drewsum/USB_Hub/README.md

# USB_Hub
A DIY USB hub with digital monitoring on all ports
