drewsum/USB_Hub/(threads)

Thread 1 (2020-08-25):

Use Correct USB Load Switches with USB Hub IC

drewsum, 2020-08-25:
Use something like this: TPS2044

https://www.ti.com/lit/ug/sllu190/sllu190.pdf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

Closed 2023-11-11.

Thread 4 (2023-11-11):

Rev A Issues/ECOs

drewsum, 2023-11-11:
Rev A design will not enumerate properly as built:

1. External EEPROM was problematic to program. Consider removing.
2. Missing 1.5k pullup resistor on upstream facing port D+. This tells the upstream facing port this is a full speed device so that it can be enumerated. I added an 0805 1.5k pullup from C14.1.1 to R905.1

drewsum, 2023-11-11:
See https://e2e.ti.com/support/interface-group/interface/f/interface-forum/768124/tusb2046b-tusb2046b-usb-detection-issue for a complete circuit, I was missing a ton of stuff
