drewsum/USB_Hub/hdw/USB_Hub/USB_Hub.pdf

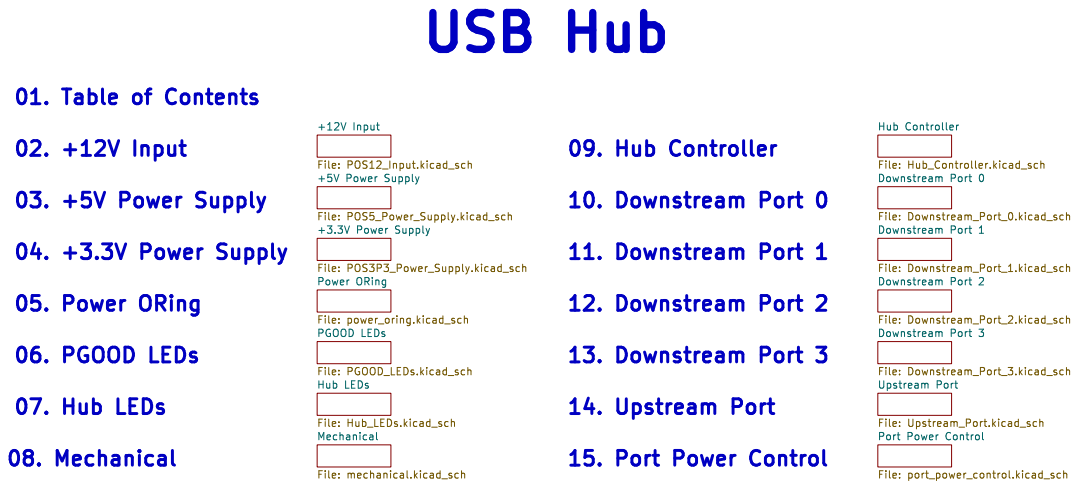
[picture p1: page 1]

Id: 1/15 Title: USB Hub

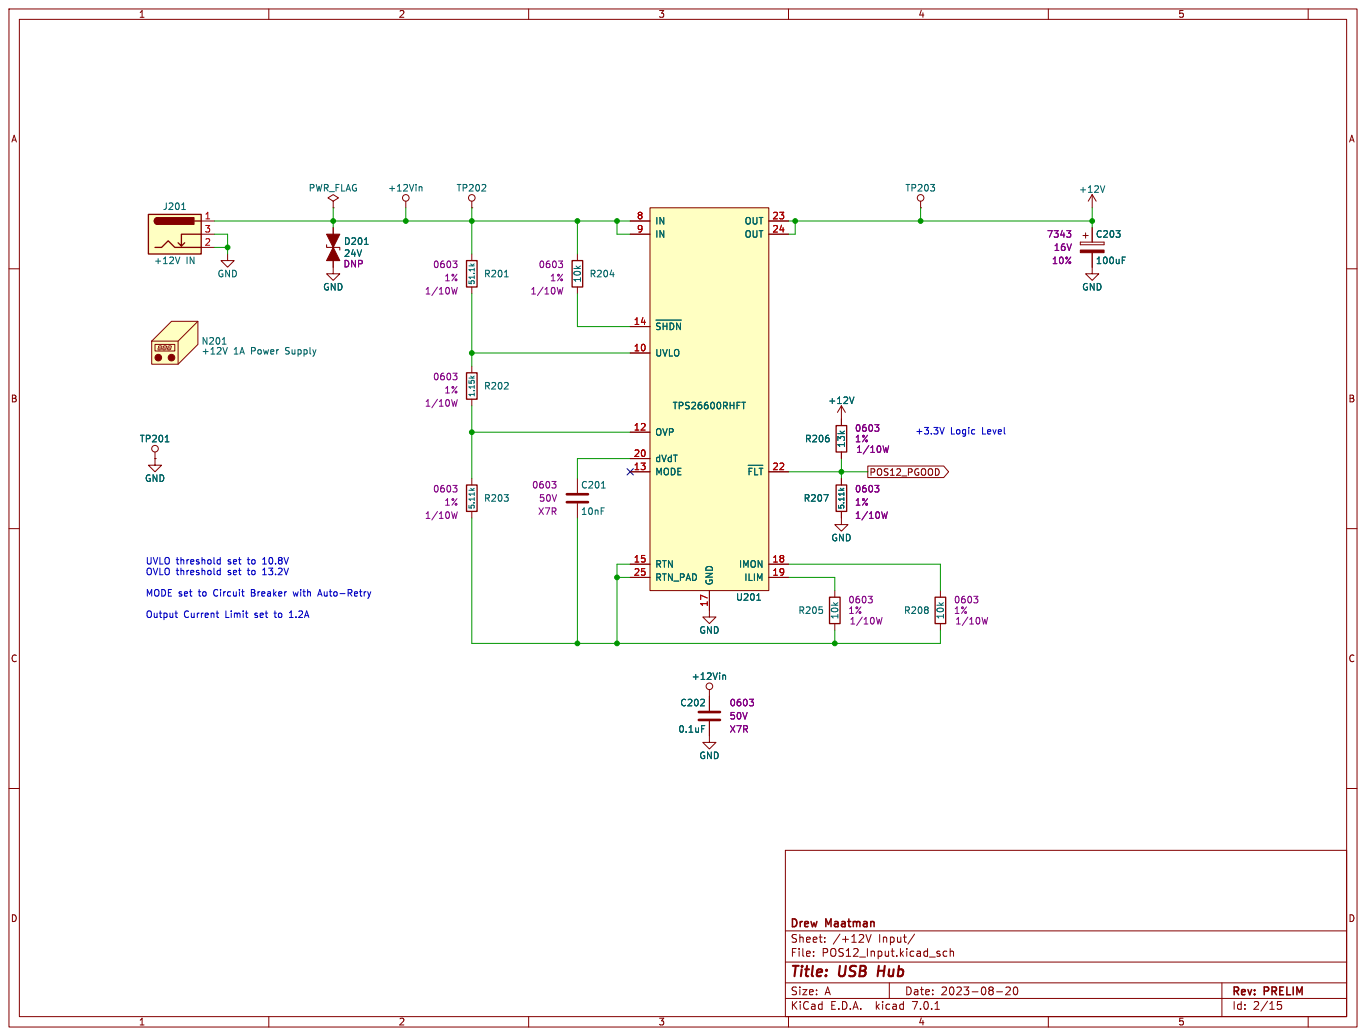
[picture p2: page 2]

Output Current Limit set to 1.2A

Id: 2/15 Title: USB Hub

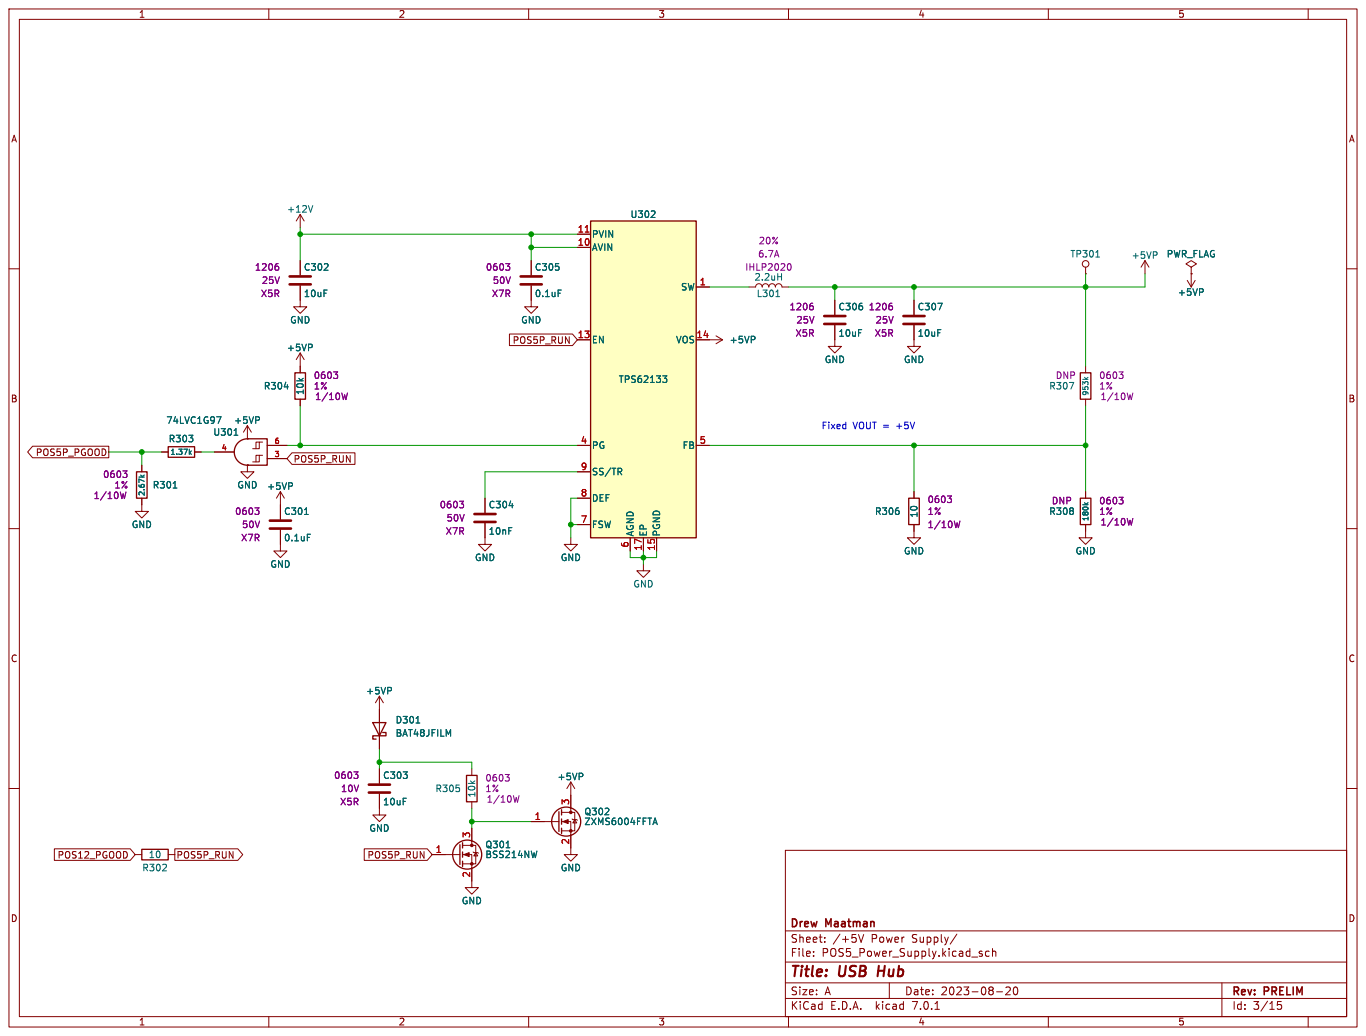
[picture p3: page 3]

6 FSW 7 DEF 8 SS/TR 9 U302 TPS62133 GND

6 FSW 7 DEF 8 SS/TR 9 C302

Id: 3/15 Title: USB Hub

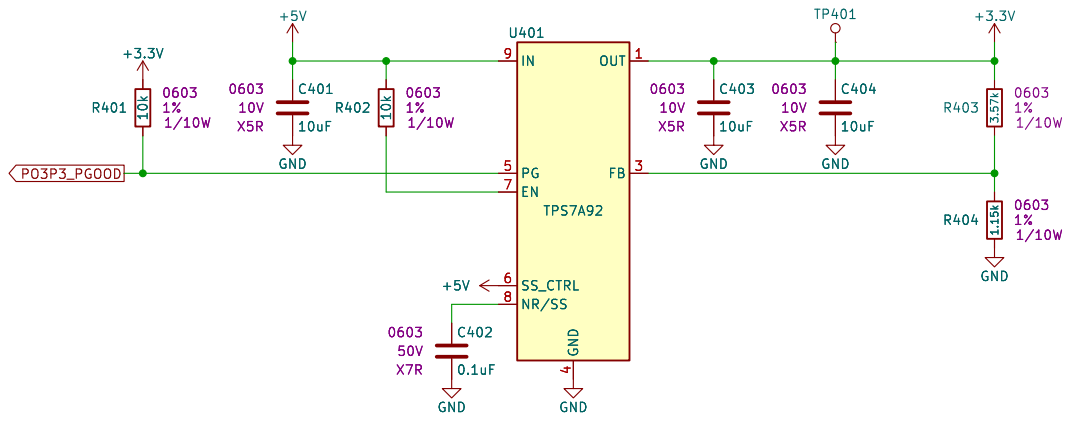
[picture p4: page 4]

4 PG 5 SS_CTRL 6 EN 7 NR/SS 8

Id: 4/15 Title: USB Hub

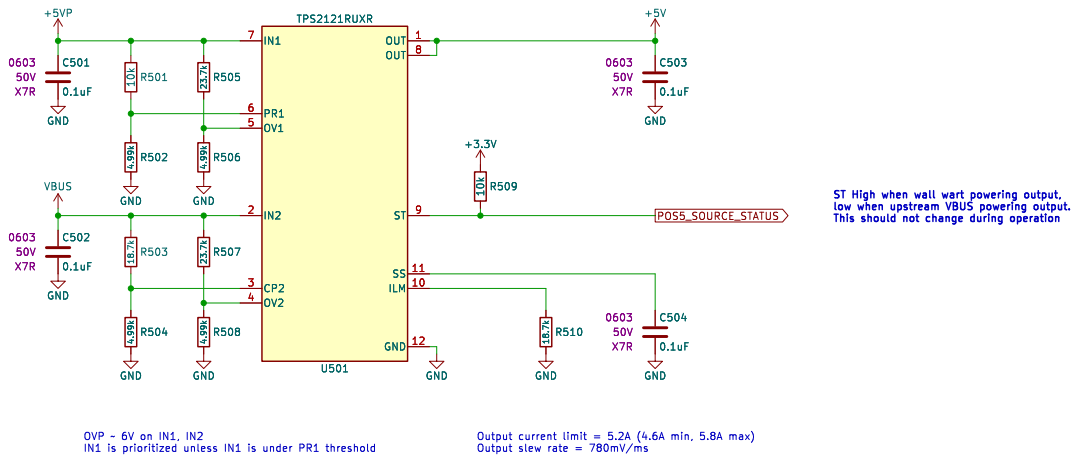
[picture p5: page 5]

ST High when wall wart powering output,
low when upstream VBUS powering output. This should not change during operation

Output slew rate = 780mV/ms OVP ~ 6V on IN1, IN2

Output current limit = 5.2A (4.6A min, 5.8A max)

Id: 5/15 Title: USB Hub

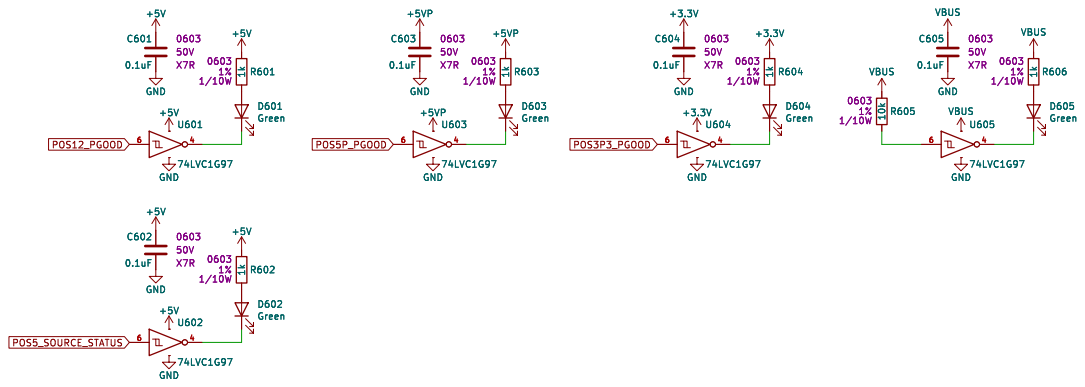
[picture p6: page 6]

Id: 6/15 Title: USB Hub

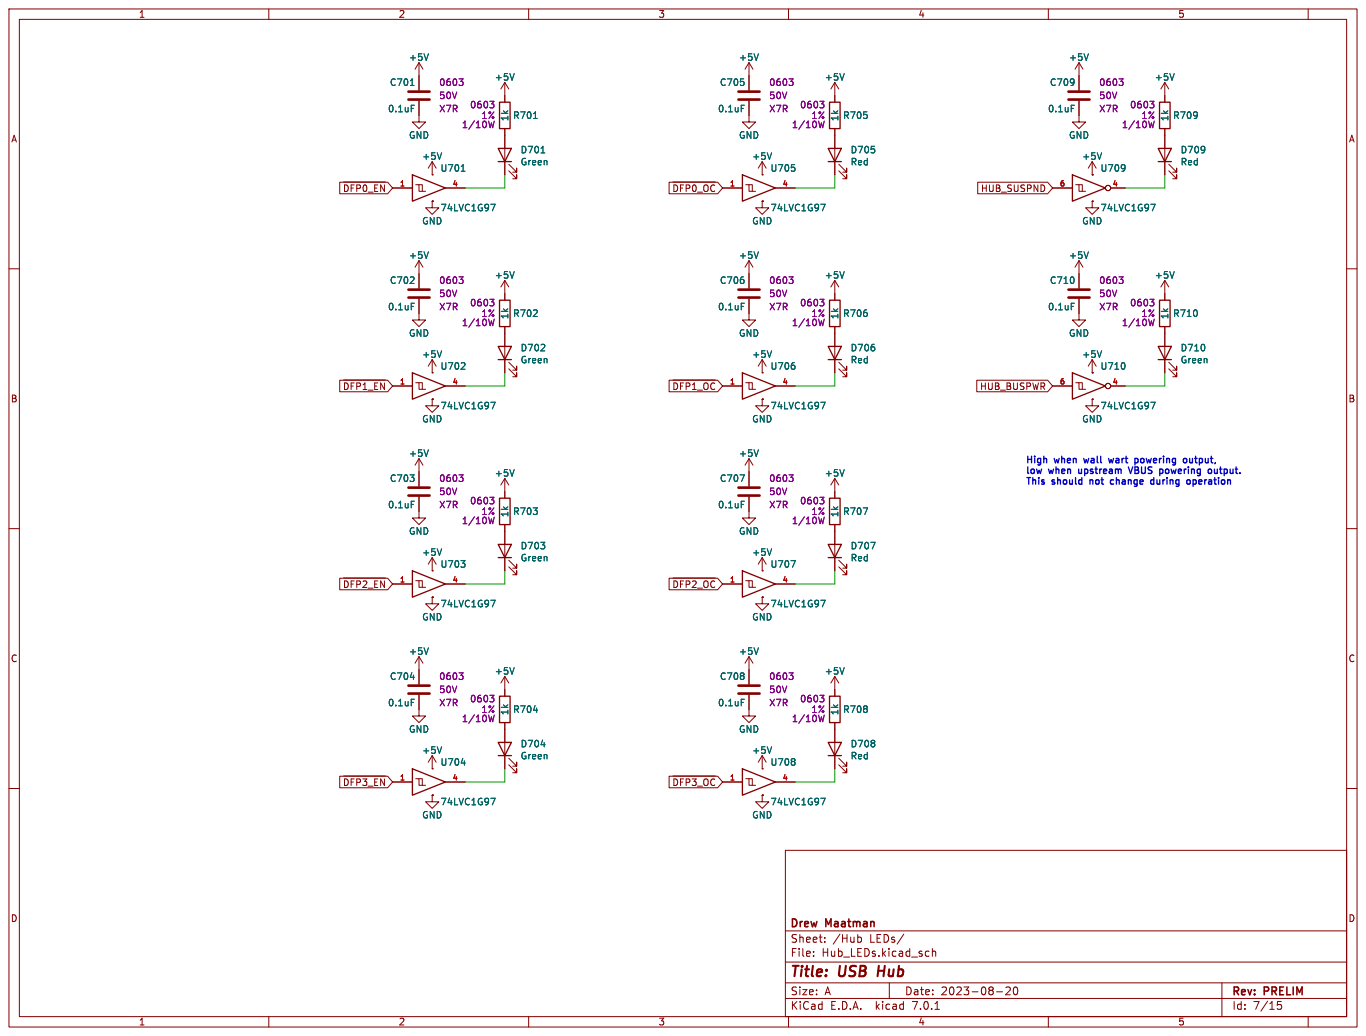
[picture p7: page 7]

low when upstream VBUS powering output. This should not change during operation U702

High when wall wart powering output,

Id: 7/15 Title: USB Hub

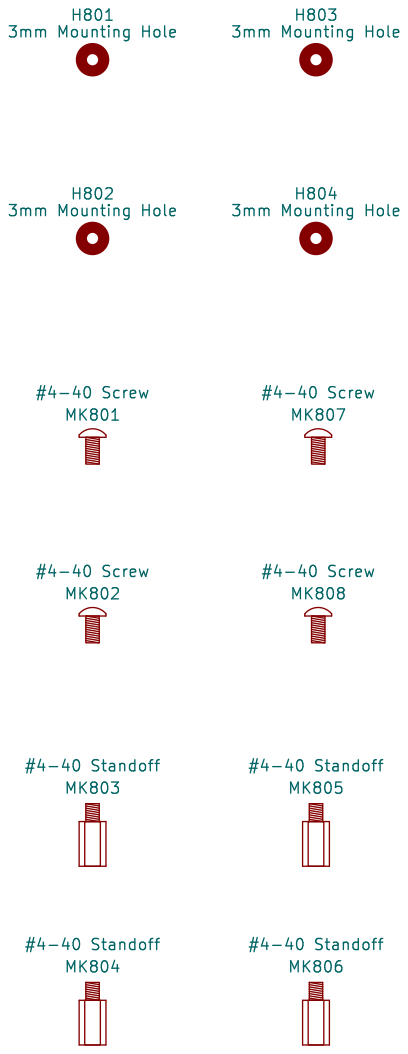
[picture p8: page 8]

Id: 8/15 Title: USB Hub

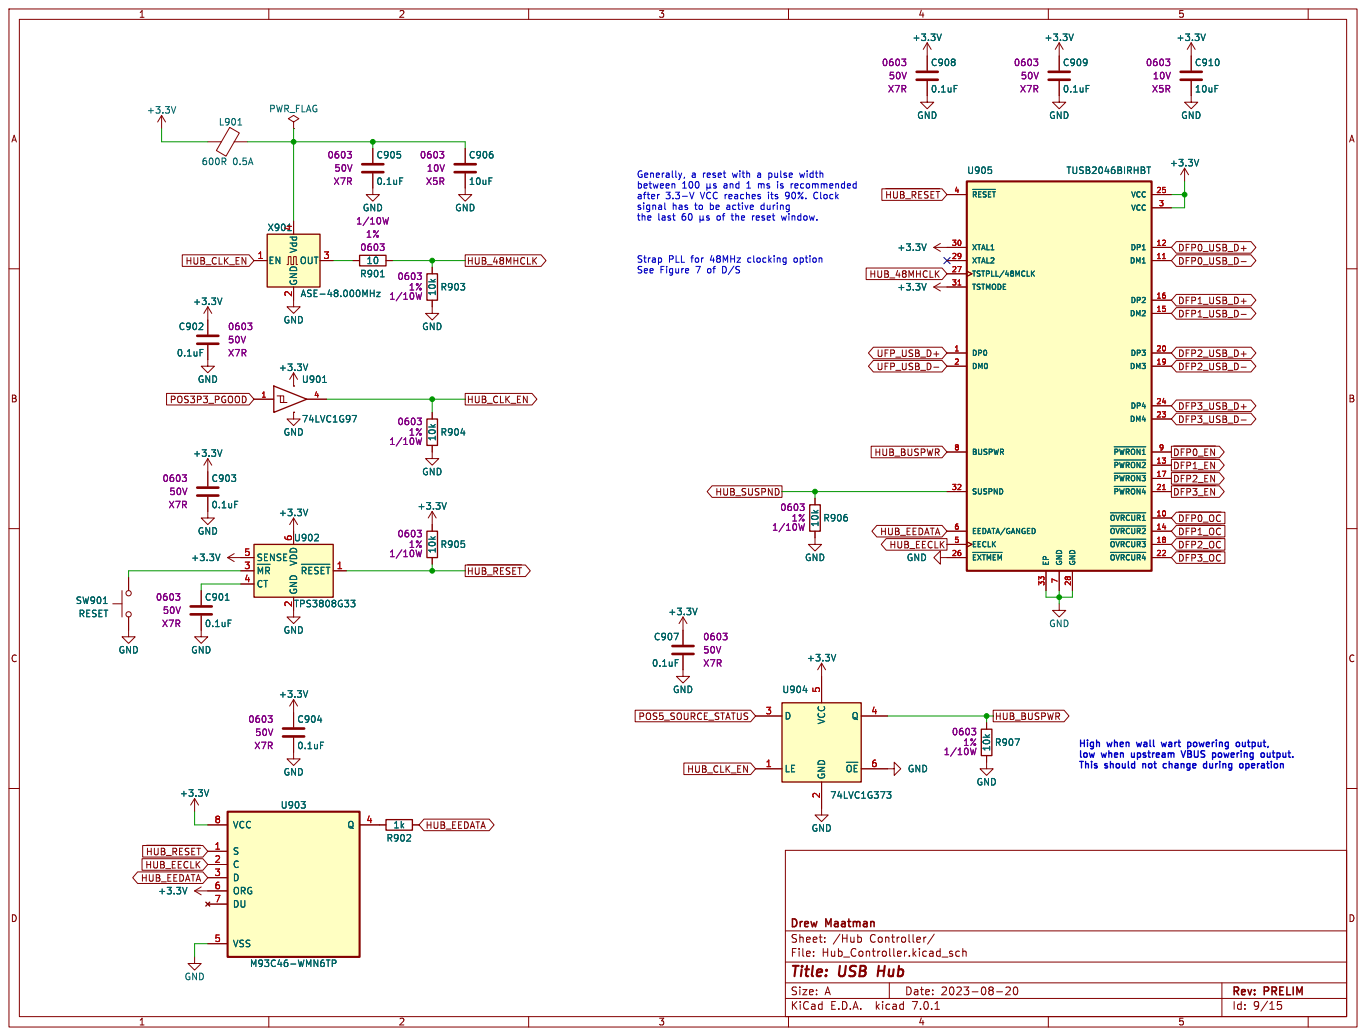
[picture p9: page 9]

Generally, a reset with a pulse width
between 100 þÿ¼sand 1 ms is recommended
signal has to be active during

2 ~{MR} 3 CT 4 SENSE 5 VDD

Id: 9/15 Title: USB Hub

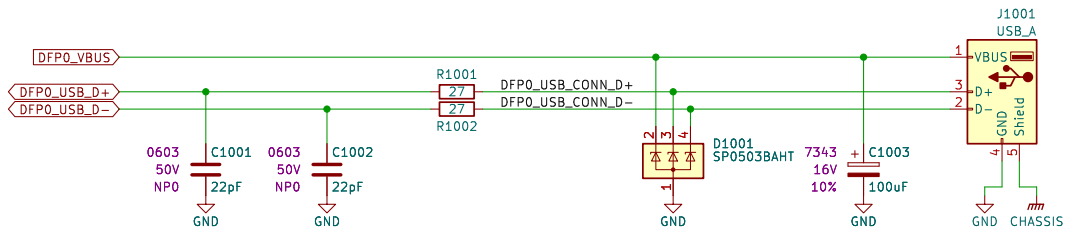
[picture p10: page 10]

Id: 10/15 Title: USB Hub

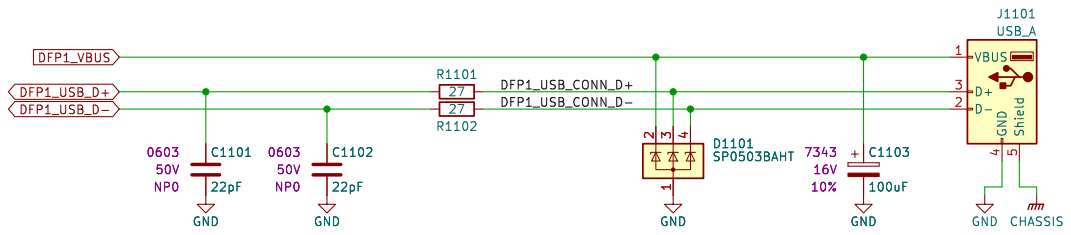
[picture p11: page 11]

Id: 11/15 Title: USB Hub

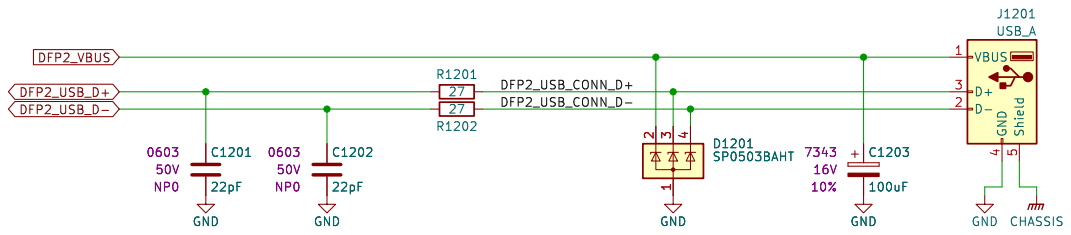
[picture p12: page 12]

Id: 12/15 Title: USB Hub

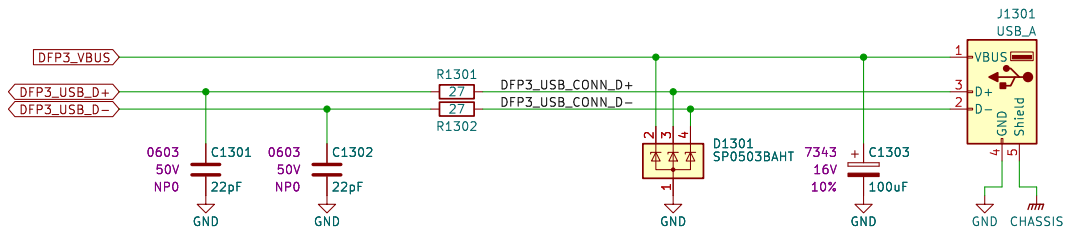
[picture p13: page 13]

Id: 13/15 Title: USB Hub

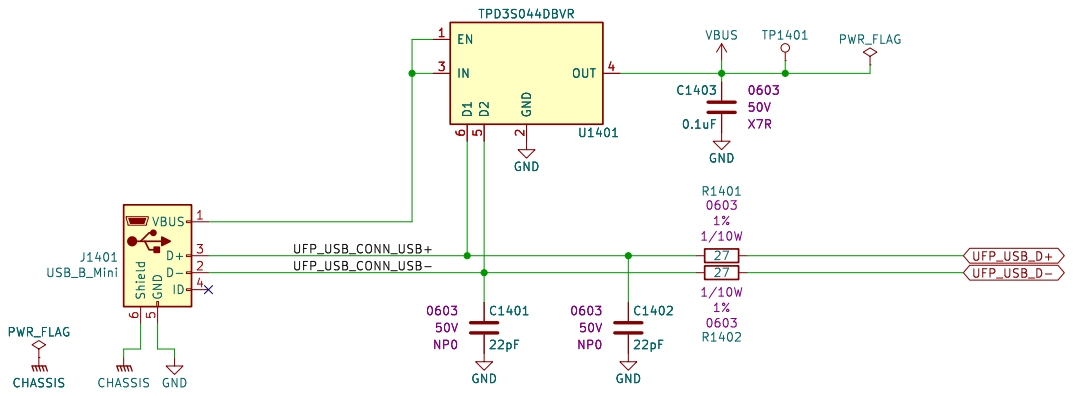
[picture p14: page 14]

Id: 14/15 Title: USB Hub

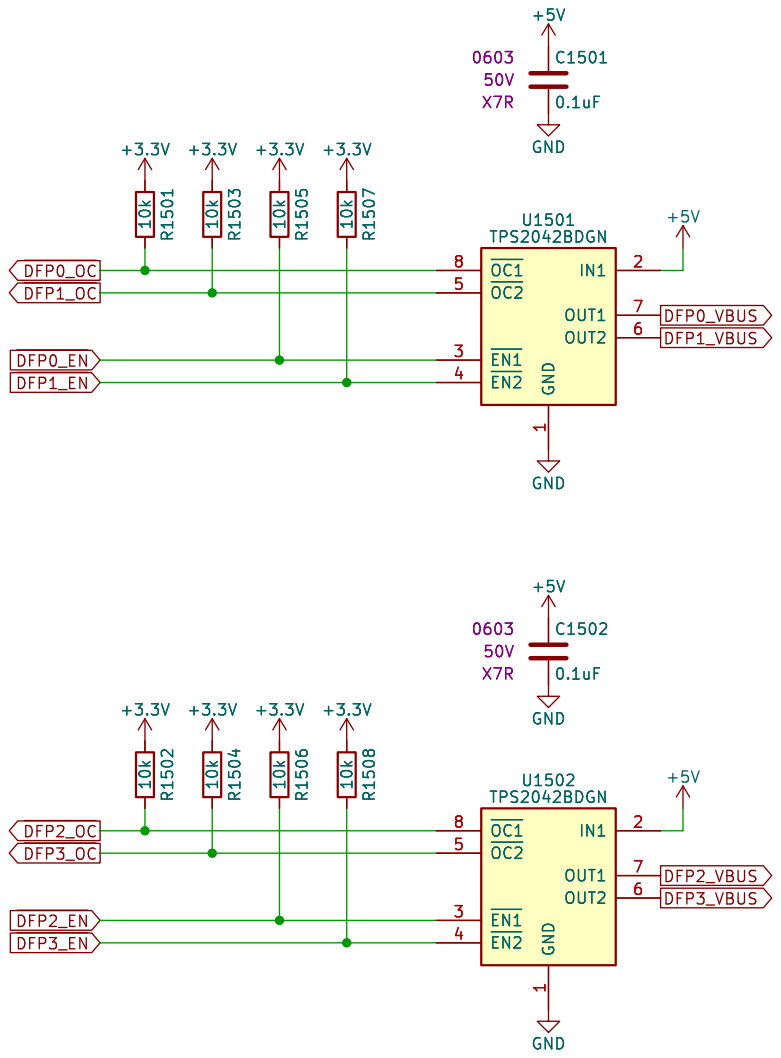
[picture p15: page 15]

Id: 15/15 Title: USB Hub
