drewsum/USB_Hub/hdw/USB_Hub/USB_Hub.kicad_pcb

## KiCad design hdw/USB_Hub/USB_Hub.kicad_pcb (2023-11-07)

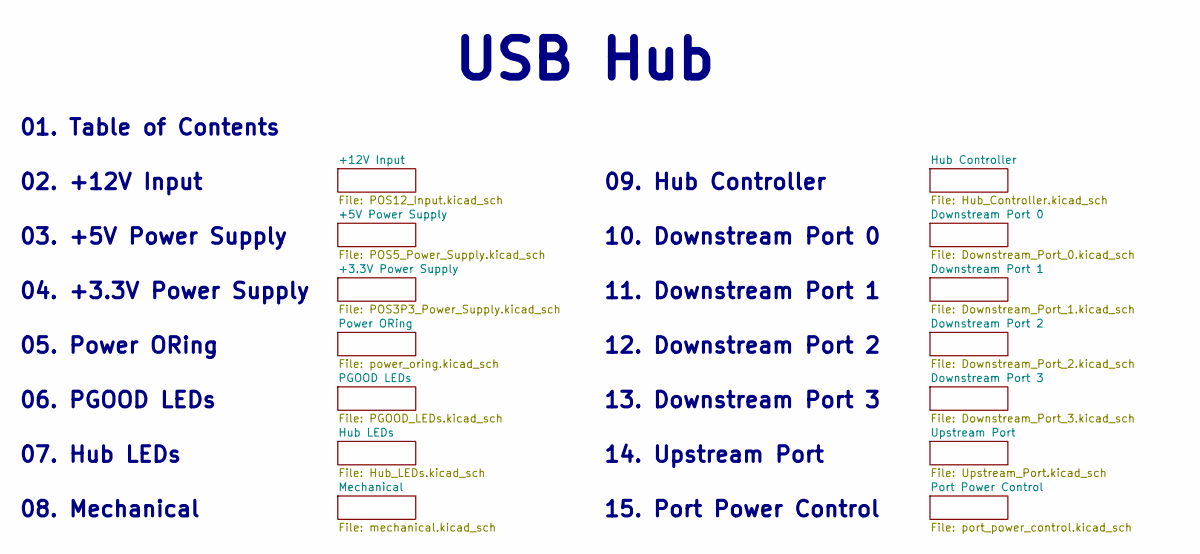
[picture p16: schematic USB_Hub.kicad_sch, USB Hub]

Notes on the sheet:
10. Downstream Port 0
05. Power ORing
03. +5V Power Supply
09. Hub Controller
06. PGOOD LEDs
13. Downstream Port 3
07. Hub LEDs
12. Downstream Port 2
01. Table of Contents
14. Upstream Port
USB Hub
04. +3.3V Power Supply
15. Port Power Control
11. Downstream Port 1
08. Mechanical
02. +12V Input

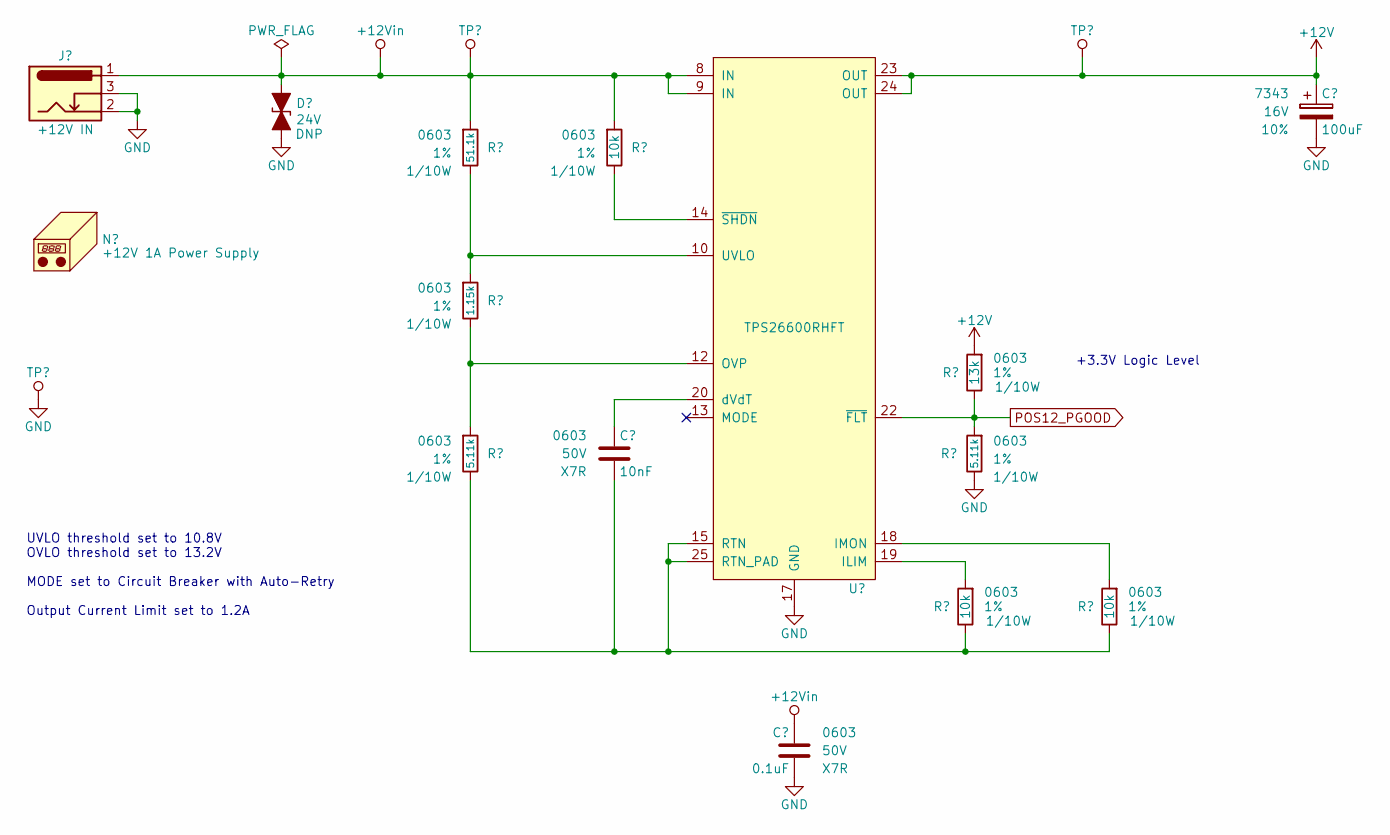
[picture p17: schematic POS12_Input.kicad_sch, USB Hub]

Parts:
C201: 10nF; C_0603; Voltage 50V; Digi-Key PN 399-7842-1-ND
C202: 0.1uF; C_0603; Voltage 50V; Digi-Key PN 1276-1935-1-ND
C203: 100uF; CP_EIA-7343-43_Kemet-X; Voltage 16V; Tolerance 10%; Digi-Key PN 718-1102-1-ND
D201: 24V; D_SMA; Digi-Key PN SMAJ24CALFCT-ND
J201: +12V IN; BARREL_JACK
N201: +12V 1A Power Supply; Digi-Key PN 993-1335-ND
R201: 51.1k; R_0603; Tolerance 1%; Digi-Key PN 541-3009-1-ND
R202: 1.15k; R_0603; Tolerance 1%; Digi-Key PN 541-1.15KHCT-ND
R203, R207: 5.11k; R_0603; Tolerance 1%; Digi-Key PN 541-5.11KHCT-ND
R204, R205, R208: 10k; R_0603; Tolerance 1%; Digi-Key PN 541-10.0KHCT-ND
R206: 13k; R_0603; Tolerance 1%; Digi-Key PN 541-13.0KHCT-ND
TP201: TP; PinHeader_1x01_P2.54mm_Horizontal
TP202, TP203: TP; Test_Point
U201: TPS26600RHFT; QFN-24-1EP_4x5mm_Pitch0.5mm; Digi-Key PN 296-45478-1-ND

Connections:
+12V: C203.1, R206.1, TP203.1 (TP), U201.23 (OUT), U201.24 (OUT); also elsewhere on the board
+12Vin: C202.1, D201.1 (A1), J201.1, R201.1, R204.1, TP202.1 (TP), U201.8 (IN), U201.9 (IN)
GND: C202.2, C203.2, D201.2 (A2), J201.2, J201.3, R207.2, TP201.1 (TP), U201.17 (GND); also elsewhere on the board
unnamed: R205.1, U201.19 (ILIM)
unnamed: R208.1, U201.18 (IMON)
unnamed: R202.2, R203.1, U201.12 (OVP)
unnamed: C201.2, R203.2, R205.2, R208.2, U201.15 (RTN), U201.25 (RTN_PAD)
unnamed: R201.2, R202.1, U201.10 (UVLO)
unnamed: C201.1, U201.20 (dVdT)
unnamed: R204.2, U201.14 (~SHDN)
POS12_PGOOD: R206.2, R207.1, U201.22 (~FLT); also elsewhere on the board

Notes on the sheet:
UVLO threshold set to 10.8V OVLO threshold set to 13.2V MODE set to Circuit Breaker with Auto-Retry Output Current Limit set to 1.2A
+3.3V Logic Level

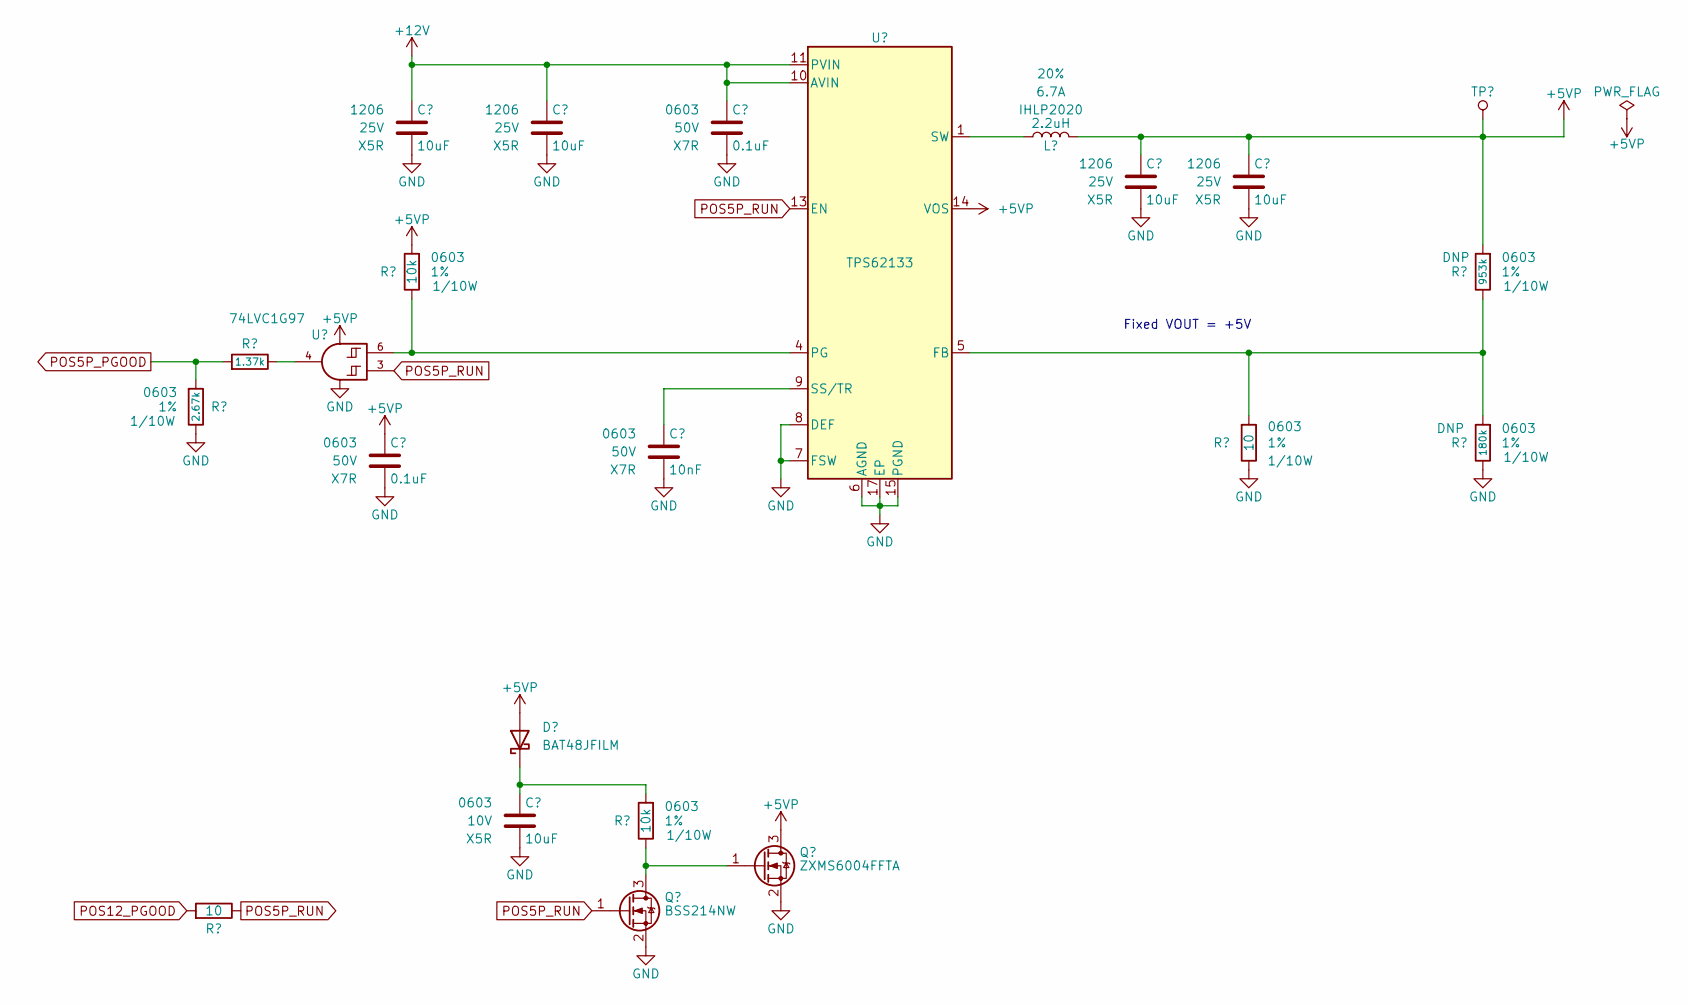
[picture p18: schematic POS5_Power_Supply.kicad_sch, USB Hub]

Parts:
C301, C305: 0.1uF; C_0603; Voltage 50V; Digi-Key PN 1276-1935-1-ND
C302, C306, C307, C308: 10uF; C_1206; Voltage 25V; Digi-Key PN 399-8153-1-ND
C303: 10uF; C_0603; Voltage 10V; Digi-Key PN 399-8153-1-ND
C304: 10nF; C_0603; Voltage 50V; Digi-Key PN 399-7842-1-ND
D301: BAT48JFILM; D_SOD-323; Digi-Key PN 497-5711-1-ND
L301: 2.2uH; L_Vishay_IHLP-2020; Tolerance 20%; Digi-Key PN 541-1236-1-ND
Q301: BSS214NW; SOT-323_SC-70; Digi-Key PN BSS214NWH6327XTSA1CT-ND
Q302: ZXMS6004FFTA; SOT-23; Digi-Key PN ZXMS6004FFCT-ND
R301: 2.67k; R_0603; Tolerance 1%; Digi-Key PN 541-2.67KHCT-ND
R302, R306: 10; R_0603; Tolerance 1%; Digi-Key PN 541-2982-1-ND
R303: 1.37k; R_0603; Tolerance 1%; Digi-Key PN 541-1.37KHCT-ND
R304, R305: 10k; R_0603; Tolerance 1%; Digi-Key PN 541-10.0KHCT-ND
R307: 953k; R_0603; Tolerance 1%; Digi-Key PN 541-953KHCT-ND
R308: 180k; R_0603; Tolerance 1%; Digi-Key PN 541-180KHCT-ND
TP301: TP; Test_Point
U301: 74LVC1G97; SOT-363_SC-70-6; Digi-Key PN 1727-1772-1-ND
U302: TPS62133; QFN-16-1EP_3x3mm_P0.5mm_EP1.75x1.75mm; Digi-Key PN 296-30225-1-ND

Connections:
+5VP: C301.1, C306.1, C307.1, D301.2 (A), L301.2, Q302.3 (D), R304.1, R307.1, TP301.1 (TP), U301.5 (VCC), U302.14 (VOS); also elsewhere on the board
+12V: C302.1, C305.1, C308.1, U302.10 (AVIN), U302.11 (PVIN), U302.12 (PVIN); also elsewhere on the board
GND: C301.2, C302.2, C303.2, C304.2, C305.2, C306.2, C307.2, C308.2, Q301.2 (S), Q302.2 (S), R301.2, R306.2, R308.2, U301.1 (GND), U301.2 (GND), U302.6 (AGND), U302.7 (FSW), U302.8 (DEF), U302.15 (PGND), U302.16 (PGND), U302.17 (EP); also elsewhere on the board
unnamed: C303.1, D301.1 (K), R305.1
unnamed: L301.1, U302.1 (SW), U302.2 (SW), U302.3 (SW)
unnamed: Q301.3 (D), Q302.1 (G), R305.2
unnamed: R303.2, U301.4
unnamed: R306.1, R307.2, R308.1, U302.5 (FB)
unnamed: R304.2, U301.6, U302.4 (PG)
unnamed: C304.1, U302.9 (SS/TR)
POS5P_PGOOD: R301.1, R303.1; also elsewhere on the board
POS5P_RUN: Q301.1 (G), R302.2, U301.3, U302.13 (EN)
POS12_PGOOD: R302.1; also elsewhere on the board

Notes on the sheet:
Fixed VOUT = +5V

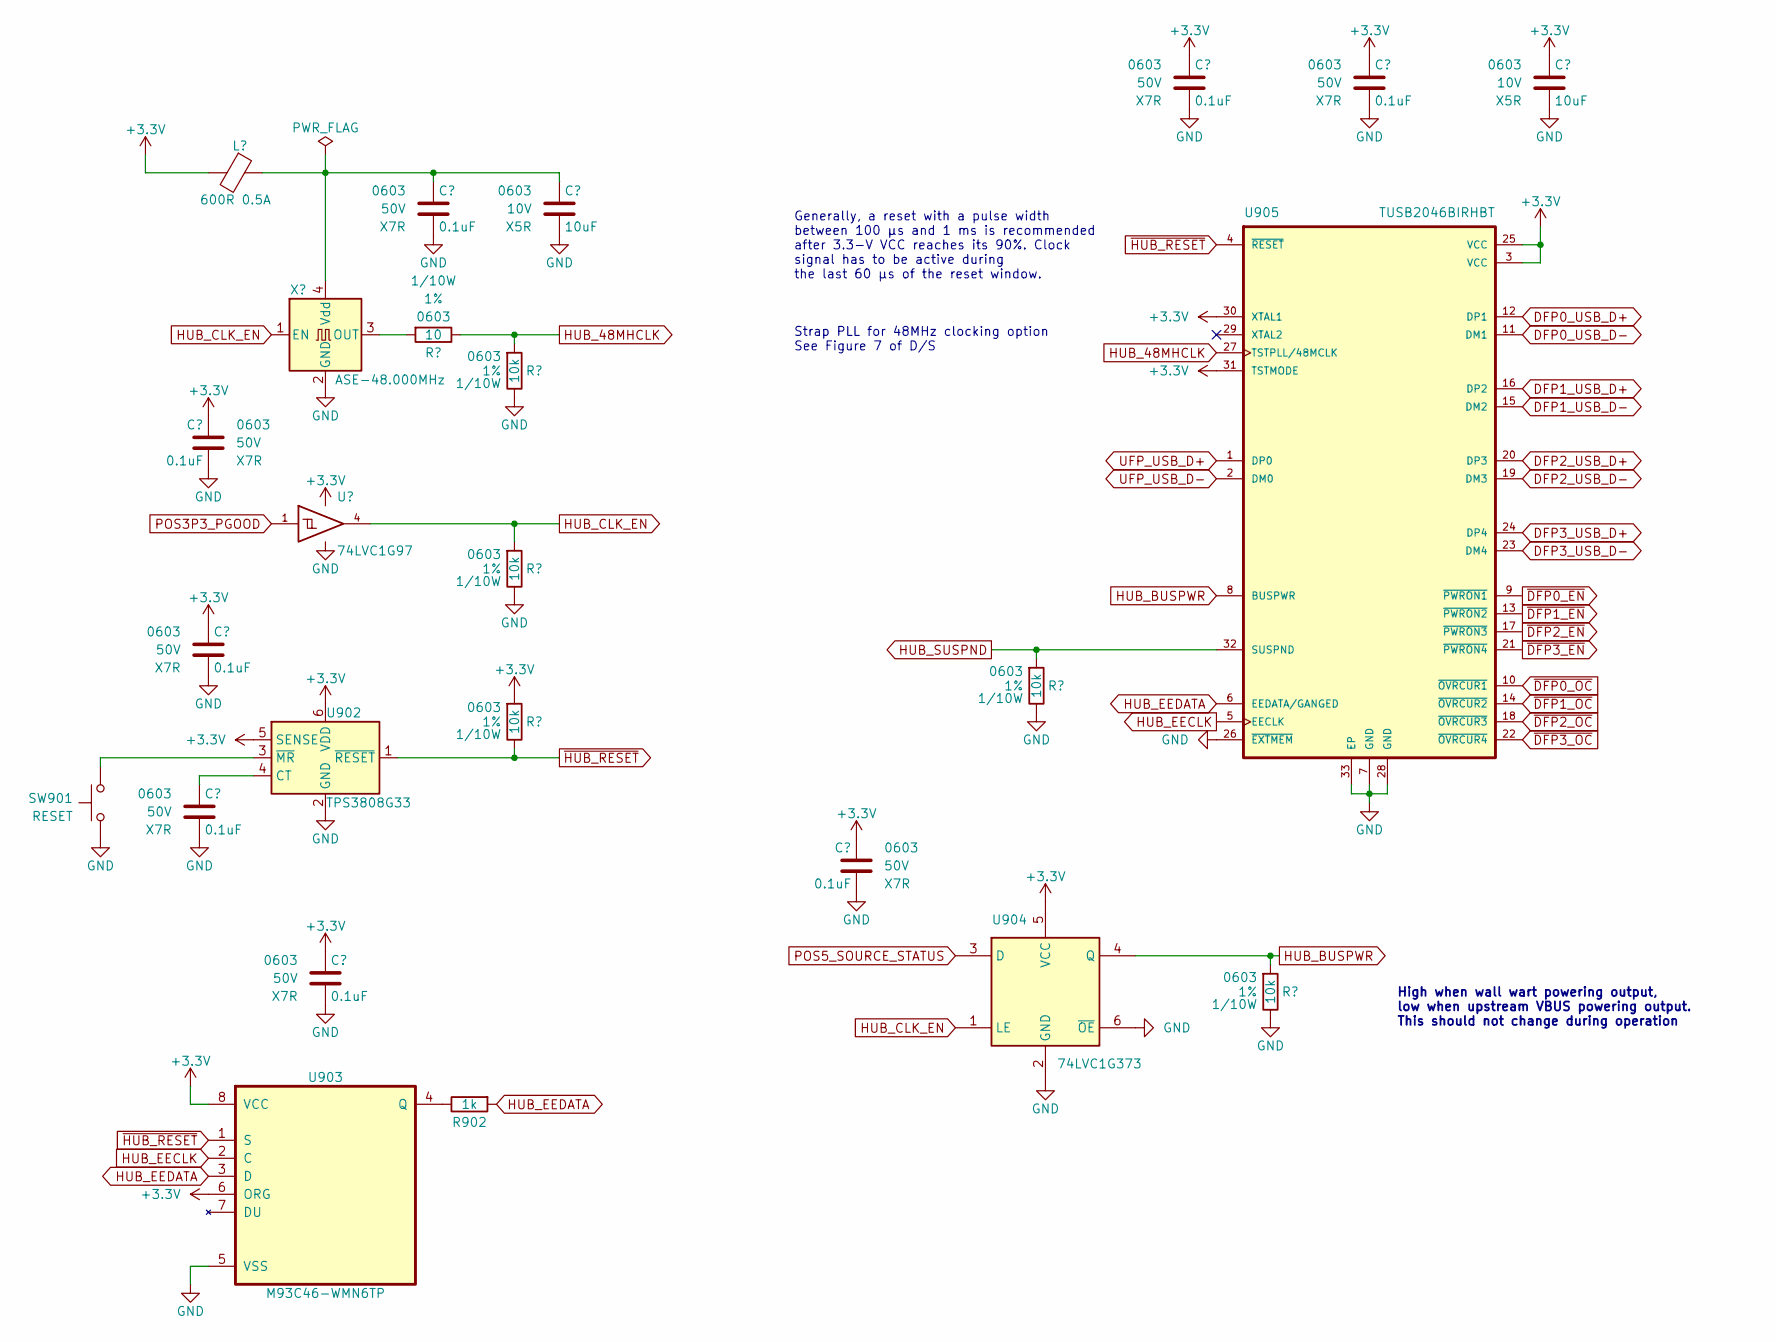
[picture p19: schematic Hub_Controller.kicad_sch, USB Hub]

Parts:
C901, C902, C903, C904, C905, C907, C908, C909: 0.1uF; C_0603; Voltage 50V; Digi-Key PN 1276-1935-1-ND
C906, C910: 10uF; C_0603; Voltage 10V; Digi-Key PN 399-8153-1-ND
L901: 600R 0.5A; L_0603; Digi-Key PN MH1608-601YCT-ND
R901: 10; R_0603; Tolerance 1%; Digi-Key PN 541-2982-1-ND
R902: 1k; R_0603; Tolerance 1%; Digi-Key PN 541-1.00KHCT-ND
R903, R904, R905, R906, R907: 10k; R_0603; Tolerance 1%; Digi-Key PN 541-10.0KHCT-ND
SW901: RESET; SW_PUSH_6mm
U901: 74LVC1G97; SOT-363_SC-70-6; Digi-Key PN 1727-1772-1-ND
U902: TPS3808G33; SOT-23-6; Digi-Key PN 296-17195-1-ND
U903: M93C46-WMN6TP; SOIC-8_3.9x4.9mm_P1.27mm; Digi-Key PN 497-5090-1-ND
U904: 74LVC1G373; SOT-363_SC-70-6; Digi-Key PN 296-18775-1-ND
U905: TUSB2046BIRHBT; VQFN-32-1EP_5x5mm_P0.5mm_EP3.5x3.5mm; Digi-Key PN 296-27130-1-ND
X901: ASE-48.000MHz; Oscillator_SMD_Abracon_ASE-4Pin_3.2x2.5mm; Digi-Key PN 535-ASE-48.000MHZ-L-C-TCT-ND

Connections:
DFP0_USB_D+: U905.12 (DP1); also elsewhere on the board
DFP0_USB_D-: U905.11 (DM1); also elsewhere on the board
DFP1_USB_D+: U905.16 (DP2); also elsewhere on the board
DFP1_USB_D-: U905.15 (DM2); also elsewhere on the board
DFP2_USB_D+: U905.20 (DP3); also elsewhere on the board
DFP2_USB_D-: U905.19 (DM3); also elsewhere on the board
DFP3_USB_D+: U905.24 (DP4); also elsewhere on the board
DFP3_USB_D-: U905.23 (DM4); also elsewhere on the board
GND: C901.2, C902.2, C903.2, C904.2, C905.2, C906.2, C907.2, C908.2, C909.2, C910.2, R903.2, R904.2, R906.2, R907.2, SW901.1, U901.2 (GND), U901.3 (GND), U901.6 (GND), U902.2 (GND), U903.5 (VSS), U904.2 (GND), U904.6 (~OE), U905.7 (GND), U905.26 (~EXTMEM), U905.28 (GND), U905.33 (EP), X901.2 (GND); also elsewhere on the board
HUB_48MHCLK: R901.2, R903.1, U905.27 (TSTPLL/48MCLK)
HUB_BUSPWR: R907.1, U904.4 (Q), U905.8 (BUSPWR); also elsewhere on the board
HUB_CLK_EN: R904.1, U901.4, U904.1 (LE), X901.1 (EN)
HUB_EECLK: U903.2 (C), U905.5 (EECLK)
HUB_EEDATA: R902.1, U903.3 (D), U905.6 (EEDATA/GANGED)
HUB_SUSPND: R906.1, U905.32 (SUSPND); also elsewhere on the board
unnamed: C905.1, C906.1, L901.1, X901.4 (Vdd)
unnamed: C901.1, U902.4 (CT)
unnamed: SW901.2, U902.3 (~MR)
unnamed: R902.2, U903.4 (Q)
unnamed: R901.1, X901.3 (OUT)
POS3P3_PGOOD: U901.1; also elsewhere on the board
POS5_SOURCE_STATUS: U904.3 (D); also elsewhere on the board
UFP_USB_D+: U905.1 (DP0); also elsewhere on the board
UFP_USB_D-: U905.2 (DM0); also elsewhere on the board
~DFP0_EN: U905.9 (~PWRON1); also elsewhere on the board
~DFP0_OC: U905.10 (~OVRCUR1); also elsewhere on the board
~DFP1_EN: U905.13 (~PWRON2); also elsewhere on the board
~DFP1_OC: U905.14 (~OVRCUR2); also elsewhere on the board
~DFP2_EN: U905.17 (~PWRON3); also elsewhere on the board
~DFP2_OC: U905.18 (~OVRCUR3); also elsewhere on the board
~DFP3_EN: U905.21 (~PWRON4); also elsewhere on the board
~DFP3_OC: U905.22 (~OVRCUR4); also elsewhere on the board
~HUB_RESET: R905.2, U902.1 (~RESET), U903.1 (S), U905.4 (~RESET)

Notes on the sheet:
Strap PLL for 48MHz clocking option See Figure 7 of D/S
Generally, a reset with a pulse width between 100 μs and 1 ms is recommended after 3.3-V VCC reaches its 90%. Clock signal has to be active during the last 60 μs of the reset window.
High when wall wart powering output, low when upstream VBUS powering output. This should not change during operation

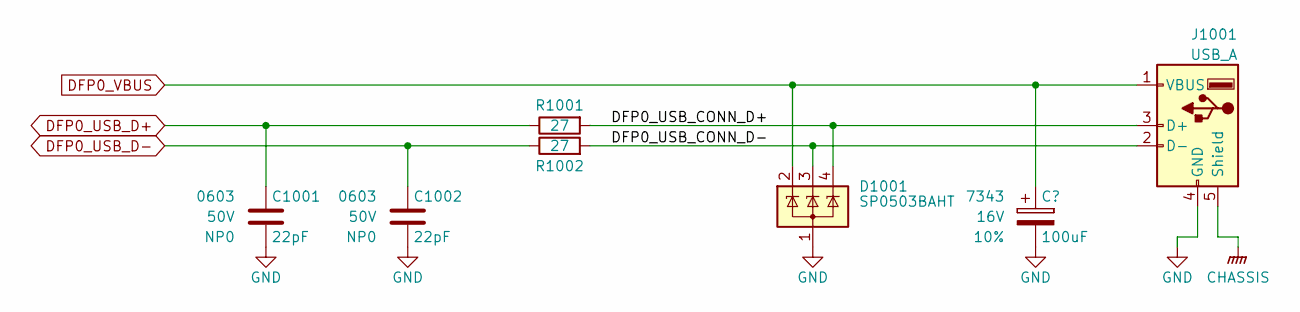
[picture p20: schematic Downstream_Port_0.kicad_sch, USB Hub]

Parts:
C1001, C1002: 22pF; C_0603; Voltage 50V; Digi-Key PN 1292-1501-1-ND
C1003: 100uF; CP_EIA-7343-43_Kemet-X; Voltage 16V; Tolerance 10%; Digi-Key PN 718-1102-1-ND
D1001: SP0503BAHT; SOT-143; Digi-Key PN F2715CT-ND
J1001: USB_A; USB_A_Wuerth_614004134726_Horizontal; Digi-Key PN 732-2731-ND
R1001, R1002: 27; R_0603; Tolerance 1%; Digi-Key PN 541-27.0HCT-ND

Connections:
/Downstream Port 0/DFP0_USB_CONN_D+: D1001.4 (K), J1001.3 (D+), R1001.1
/Downstream Port 0/DFP0_USB_CONN_D-: D1001.3 (K), J1001.2 (D-), R1002.1
CHASSIS: J1001.5 (Shield); also elsewhere on the board
DFP0_USB_D+: C1001.1, R1001.2; also elsewhere on the board
DFP0_USB_D-: C1002.1, R1002.2; also elsewhere on the board
DFP0_VBUS: C1003.1, D1001.2 (K), J1001.1 (VBUS); also elsewhere on the board
GND: C1001.2, C1002.2, C1003.2, D1001.1 (A), J1001.4 (GND); also elsewhere on the board

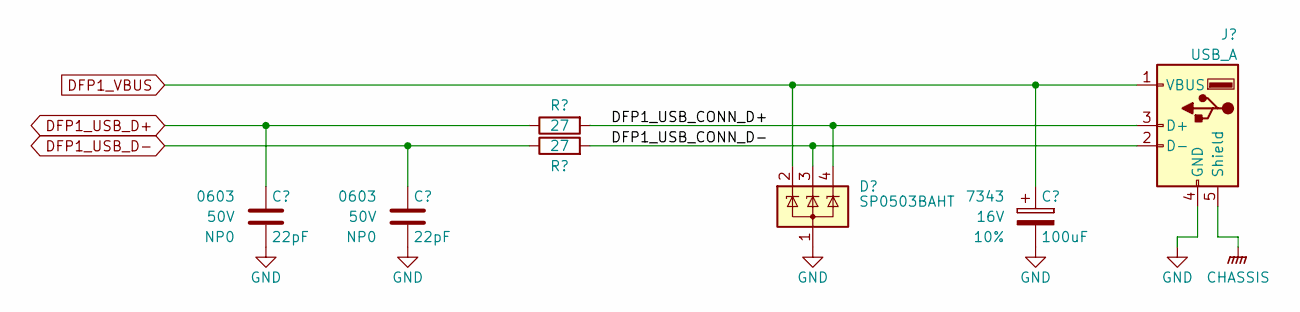
[picture p21: schematic Downstream_Port_1.kicad_sch, USB Hub]

Parts:
C1101, C1102: 22pF; C_0603; Voltage 50V; Digi-Key PN 1292-1501-1-ND
C1103: 100uF; CP_EIA-7343-43_Kemet-X; Voltage 16V; Tolerance 10%; Digi-Key PN 718-1102-1-ND
D1101: SP0503BAHT; SOT-143; Digi-Key PN F2715CT-ND
J1101: USB_A; USB_A_Wuerth_614004134726_Horizontal; Digi-Key PN 732-2731-ND
R1101, R1102: 27; R_0603; Tolerance 1%; Digi-Key PN 541-27.0HCT-ND

Connections:
/Downstream Port 1/DFP1_USB_CONN_D+: D1101.4 (K), J1101.3 (D+), R1101.1
/Downstream Port 1/DFP1_USB_CONN_D-: D1101.3 (K), J1101.2 (D-), R1102.1
CHASSIS: J1101.5 (Shield); also elsewhere on the board
DFP1_USB_D+: C1101.1, R1101.2; also elsewhere on the board
DFP1_USB_D-: C1102.1, R1102.2; also elsewhere on the board
DFP1_VBUS: C1103.1, D1101.2 (K), J1101.1 (VBUS); also elsewhere on the board
GND: C1101.2, C1102.2, C1103.2, D1101.1 (A), J1101.4 (GND); also elsewhere on the board

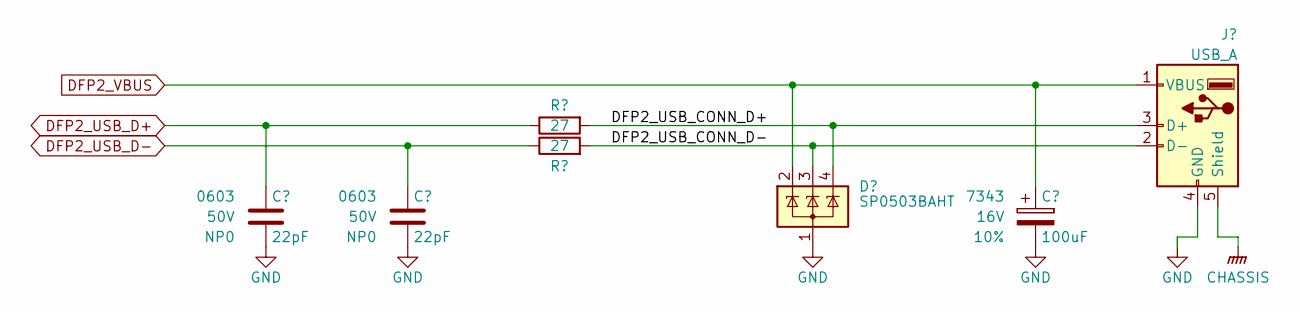
[picture p22: schematic Downstream_Port_2.kicad_sch, USB Hub]

Parts:
C1201, C1202: 22pF; C_0603; Voltage 50V; Digi-Key PN 1292-1501-1-ND
C1203: 100uF; CP_EIA-7343-43_Kemet-X; Voltage 16V; Tolerance 10%; Digi-Key PN 718-1102-1-ND
D1201: SP0503BAHT; SOT-143; Digi-Key PN F2715CT-ND
J1201: USB_A; USB_A_Wuerth_614004134726_Horizontal; Digi-Key PN 732-2731-ND
R1201, R1202: 27; R_0603; Tolerance 1%; Digi-Key PN 541-27.0HCT-ND

Connections:
/Downstream Port 2/DFP2_USB_CONN_D+: D1201.4 (K), J1201.3 (D+), R1201.1
/Downstream Port 2/DFP2_USB_CONN_D-: D1201.3 (K), J1201.2 (D-), R1202.1
CHASSIS: J1201.5 (Shield); also elsewhere on the board
DFP2_USB_D+: C1201.1, R1201.2; also elsewhere on the board
DFP2_USB_D-: C1202.1, R1202.2; also elsewhere on the board
DFP2_VBUS: C1203.1, D1201.2 (K), J1201.1 (VBUS); also elsewhere on the board
GND: C1201.2, C1202.2, C1203.2, D1201.1 (A), J1201.4 (GND); also elsewhere on the board

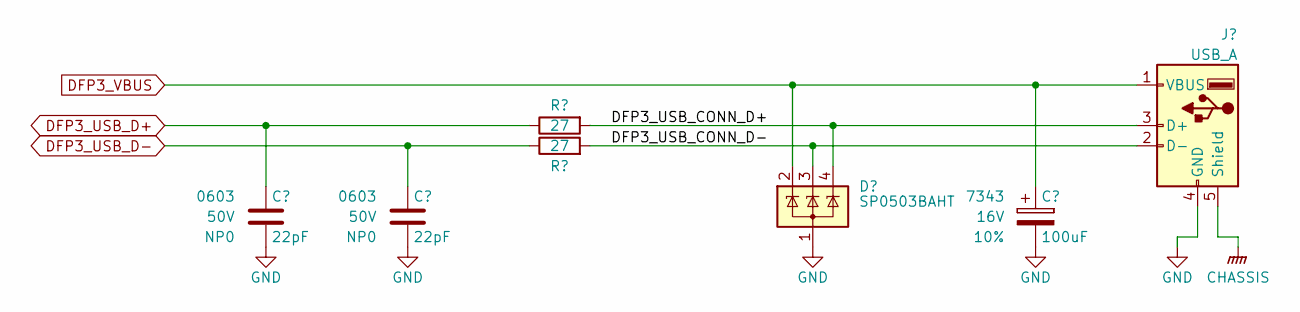
[picture p23: schematic Downstream_Port_3.kicad_sch, USB Hub]

Parts:
C1301, C1302: 22pF; C_0603; Voltage 50V; Digi-Key PN 1292-1501-1-ND
C1303: 100uF; CP_EIA-7343-43_Kemet-X; Voltage 16V; Tolerance 10%; Digi-Key PN 718-1102-1-ND
D1301: SP0503BAHT; SOT-143; Digi-Key PN F2715CT-ND
J1301: USB_A; USB_A_Wuerth_614004134726_Horizontal; Digi-Key PN 732-2731-ND
R1301, R1302: 27; R_0603; Tolerance 1%; Digi-Key PN 541-27.0HCT-ND

Connections:
/Downstream Port 3/DFP3_USB_CONN_D+: D1301.4 (K), J1301.3 (D+), R1301.1
/Downstream Port 3/DFP3_USB_CONN_D-: D1301.3 (K), J1301.2 (D-), R1302.1
CHASSIS: J1301.5 (Shield); also elsewhere on the board
DFP3_USB_D+: C1301.1, R1301.2; also elsewhere on the board
DFP3_USB_D-: C1302.1, R1302.2; also elsewhere on the board
DFP3_VBUS: C1303.1, D1301.2 (K), J1301.1 (VBUS); also elsewhere on the board
GND: C1301.2, C1302.2, C1303.2, D1301.1 (A), J1301.4 (GND); also elsewhere on the board

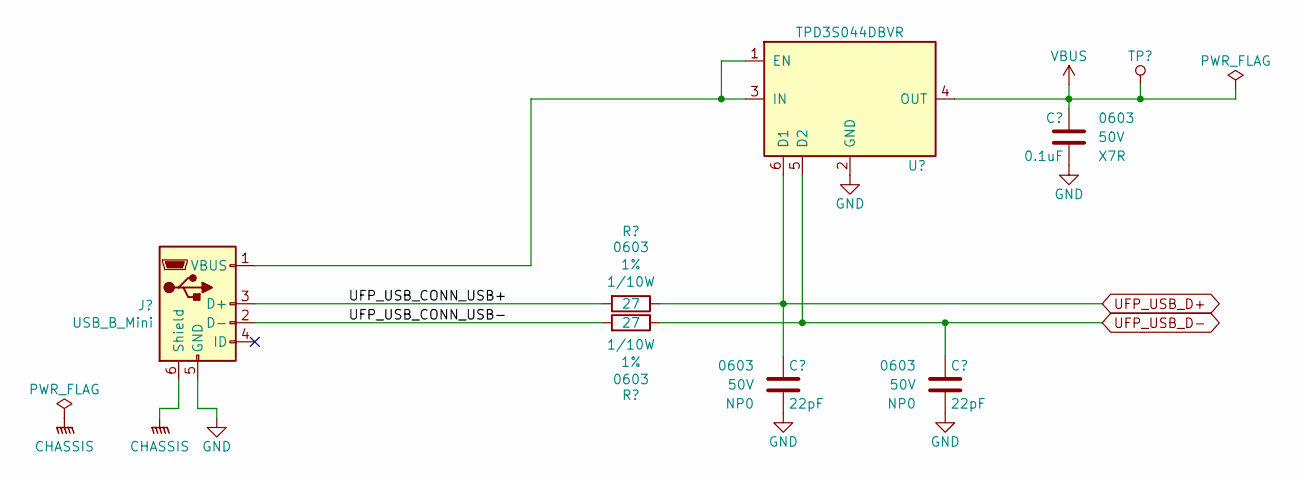
[picture p24: schematic Upstream_Port.kicad_sch, USB Hub]

Parts:
C1401, C1402: 22pF; C_0603; Voltage 50V; Digi-Key PN 1292-1501-1-ND
C1403: 0.1uF; C_0603; Voltage 50V; Digi-Key PN 1276-1935-1-ND
J1401: USB_B_Mini; USB_Mini-B; Digi-Key PN 732-2109-1-ND
R1401, R1402: 27; R_0603; Tolerance 1%; Digi-Key PN 541-27.0HCT-ND
TP1401: TP; Test_Point
U1401: TPD3S044DBVR; SOT-23-6; Digi-Key PN 296-38836-1-ND

Connections:
/Upstream Port/UFP_USB_CONN_USB+: J1401.3 (D+), R1401.1
/Upstream Port/UFP_USB_CONN_USB-: J1401.2 (D-), R1402.1
CHASSIS: J1401.6 (Shield); also elsewhere on the board
GND: C1401.2, C1402.2, C1403.2, J1401.5 (GND), U1401.2 (GND); also elsewhere on the board
unnamed: J1401.1 (VBUS), U1401.1 (EN), U1401.3 (IN)
UFP_USB_D+: C1401.1, R1401.2, U1401.6 (D1); also elsewhere on the board
UFP_USB_D-: C1402.1, R1402.2, U1401.5 (D2); also elsewhere on the board
VBUS: C1403.1, TP1401.1 (TP), U1401.4 (OUT); also elsewhere on the board

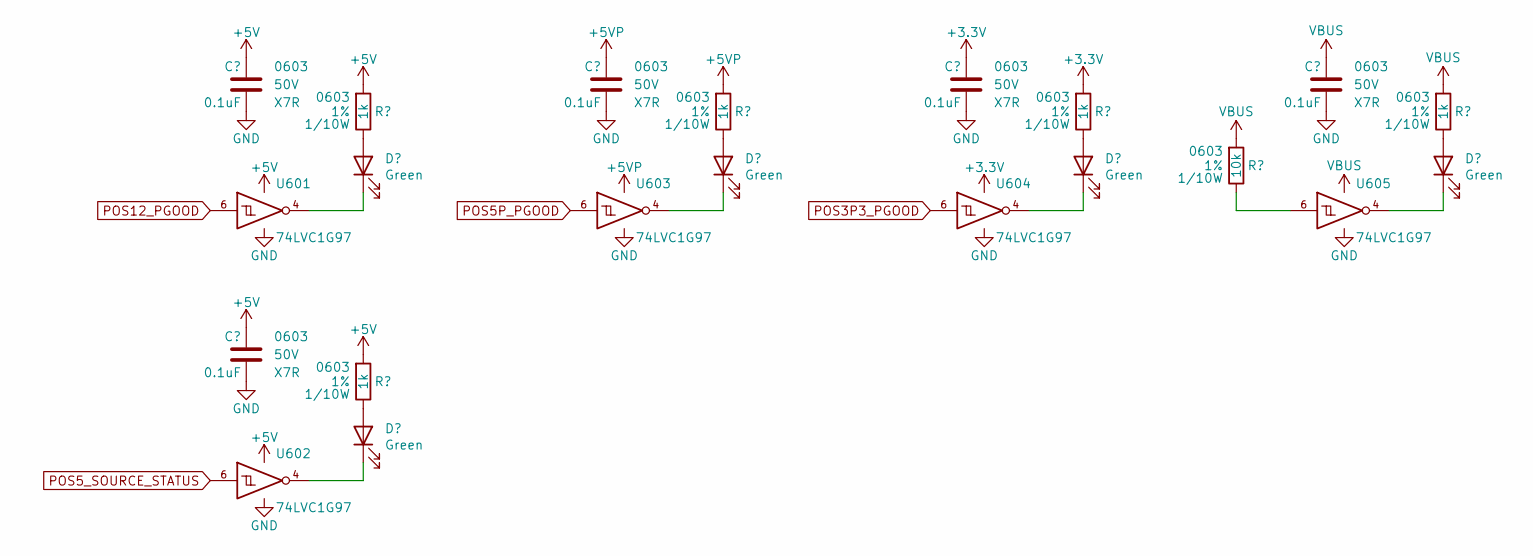
[picture p25: schematic PGOOD_LEDs.kicad_sch, USB Hub]

Parts:
C601, C602, C603, C604, C605: 0.1uF; C_0603; Voltage 50V; Digi-Key PN 1276-1935-1-ND
D601, D602, D603, D604, D605: Green; LED_0603; Digi-Key PN 754-1121-1-ND
R601, R602, R603, R604, R606: 1k; R_0603; Tolerance 1%; Digi-Key PN 541-1.00KHCT-ND
R605: 10k; R_0603; Tolerance 1%; Digi-Key PN 541-10.0KHCT-ND
U601, U602, U603, U604, U605: 74LVC1G97; SOT-363_SC-70-6; Digi-Key PN 1727-1772-1-ND

Connections:
+5VP: C603.1, R603.1, U603.1 (VCC), U603.5 (VCC); also elsewhere on the board
GND: C601.2, C602.2, C603.2, C604.2, C605.2, U601.2 (GND), U601.3 (GND), U602.2 (GND), U602.3 (GND), U603.2 (GND), U603.3 (GND), U604.2 (GND), U604.3 (GND), U605.2 (GND), U605.3 (GND); also elsewhere on the board
unnamed: D601.2 (A), R601.2
unnamed: D601.1 (K), U601.4
unnamed: D602.2 (A), R602.2
unnamed: D602.1 (K), U602.4
unnamed: D603.2 (A), R603.2
unnamed: D603.1 (K), U603.4
unnamed: D604.2 (A), R604.2
unnamed: D604.1 (K), U604.4
unnamed: D605.2 (A), R606.2
unnamed: D605.1 (K), U605.4
unnamed: R605.2, U605.6
POS3P3_PGOOD: U604.6; also elsewhere on the board
POS5P_PGOOD: U603.6; also elsewhere on the board
POS5_SOURCE_STATUS: U602.6; also elsewhere on the board
POS12_PGOOD: U601.6; also elsewhere on the board
VBUS: C605.1, R605.1, R606.1, U605.1 (VCC), U605.5 (VCC); also elsewhere on the board

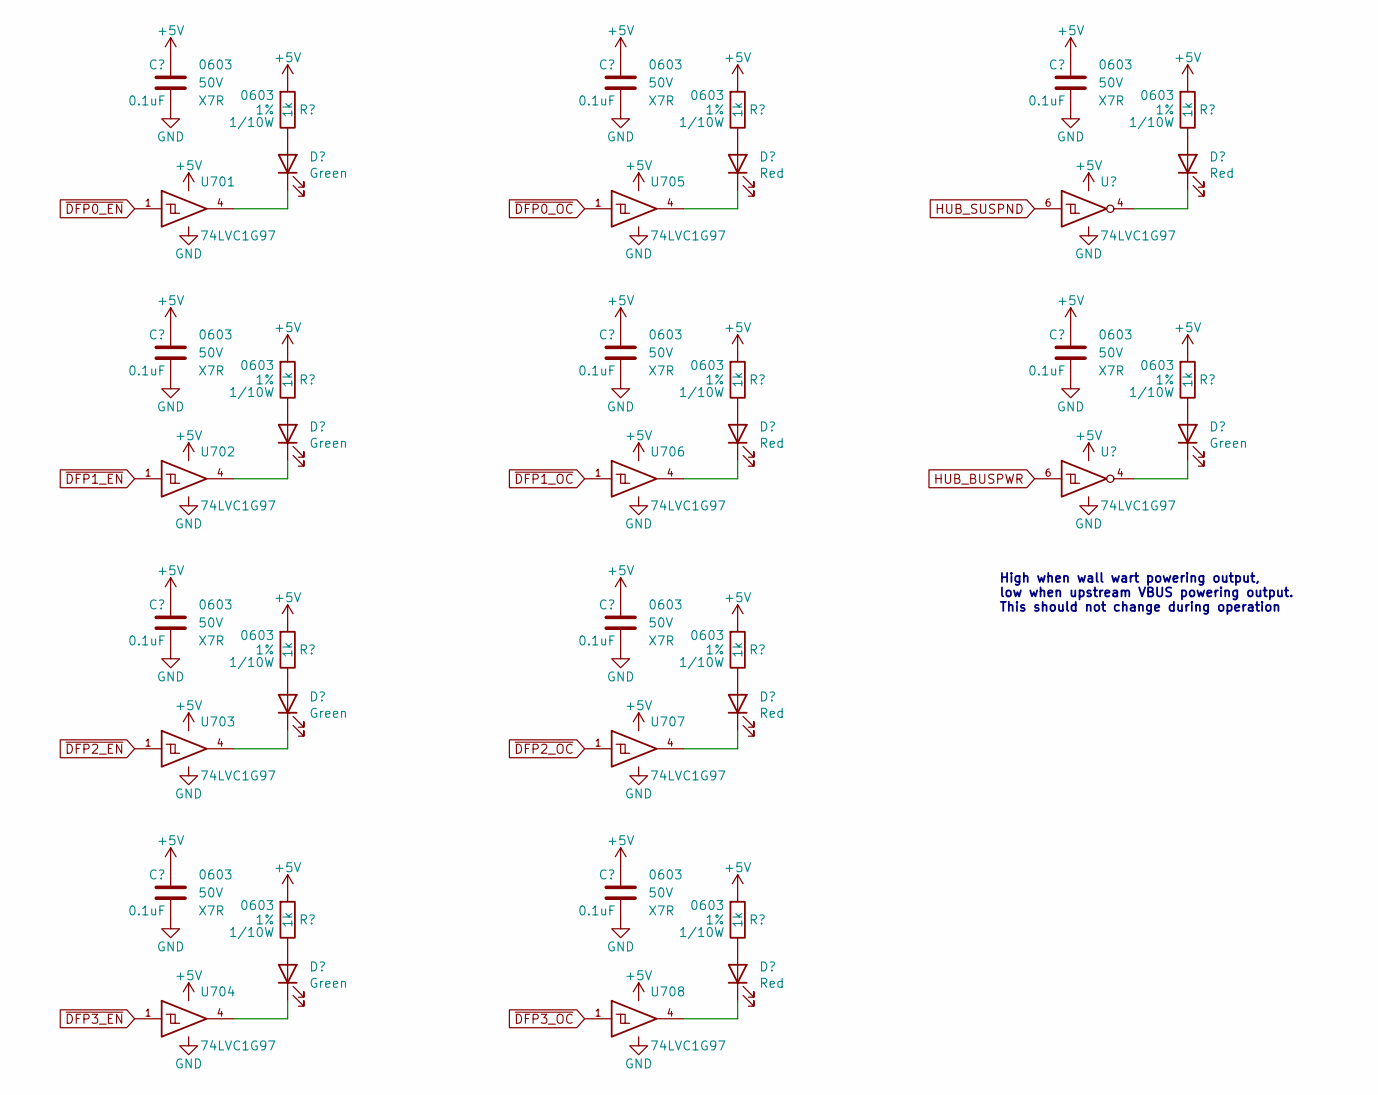
[picture p26: schematic Hub_LEDs.kicad_sch, USB Hub]

Parts:
C701, C702, C703, C704, C705, C706, C707, C708, C709, C710: 0.1uF; C_0603; Voltage 50V; Digi-Key PN 1276-1935-1-ND
D701, D702, D703, D704, D710: Green; LED_0603; Digi-Key PN 754-1121-1-ND
D705, D706, D707, D708, D709: Red; LED_0603; Digi-Key PN 754-1117-1-ND
R701, R702, R703, R704, R705, R706, R707, R708, R709, R710: 1k; R_0603; Tolerance 1%; Digi-Key PN 541-1.00KHCT-ND
U701, U702, U703, U704, U705, U706, U707, U708, U709, U710: 74LVC1G97; SOT-363_SC-70-6; Digi-Key PN 1727-1772-1-ND

Connections:
GND: C701.2, C702.2, C703.2, C704.2, C705.2, C706.2, C707.2, C708.2, C709.2, C710.2, U701.2 (GND), U701.3 (GND), U701.6 (GND), U702.2 (GND), U702.3 (GND), U702.6 (GND), U703.2 (GND), U703.3 (GND), U703.6 (GND), U704.2 (GND), U704.3 (GND), U704.6 (GND), U705.2 (GND), U705.3 (GND), U705.6 (GND), U706.2 (GND), U706.3 (GND), U706.6 (GND), U707.2 (GND), U707.3 (GND), U707.6 (GND), U708.2 (GND), U708.3 (GND), U708.6 (GND), U709.2 (GND), U709.3 (GND), U710.2 (GND), U710.3 (GND); also elsewhere on the board
HUB_BUSPWR: U710.6; also elsewhere on the board
HUB_SUSPND: U709.6; also elsewhere on the board
unnamed: D701.2 (A), R701.2
unnamed: D701.1 (K), U701.4
unnamed: D702.2 (A), R702.2
unnamed: D702.1 (K), U702.4
unnamed: D703.2 (A), R703.2
unnamed: D703.1 (K), U703.4
unnamed: D704.2 (A), R704.2
unnamed: D704.1 (K), U704.4
unnamed: D705.2 (A), R705.2
unnamed: D705.1 (K), U705.4
unnamed: D706.2 (A), R706.2
unnamed: D706.1 (K), U706.4
unnamed: D707.2 (A), R707.2
unnamed: D707.1 (K), U707.4
unnamed: D708.2 (A), R708.2
unnamed: D708.1 (K), U708.4
unnamed: D709.2 (A), R709.2
unnamed: D709.1 (K), U709.4
unnamed: D710.2 (A), R710.2
unnamed: D710.1 (K), U710.4
~DFP0_EN: U701.1; also elsewhere on the board
~DFP0_OC: U705.1; also elsewhere on the board
~DFP1_EN: U702.1; also elsewhere on the board
~DFP1_OC: U706.1; also elsewhere on the board
~DFP2_EN: U703.1; also elsewhere on the board
~DFP2_OC: U707.1; also elsewhere on the board
~DFP3_EN: U704.1; also elsewhere on the board
~DFP3_OC: U708.1; also elsewhere on the board

Notes on the sheet:
High when wall wart powering output, low when upstream VBUS powering output. This should not change during operation

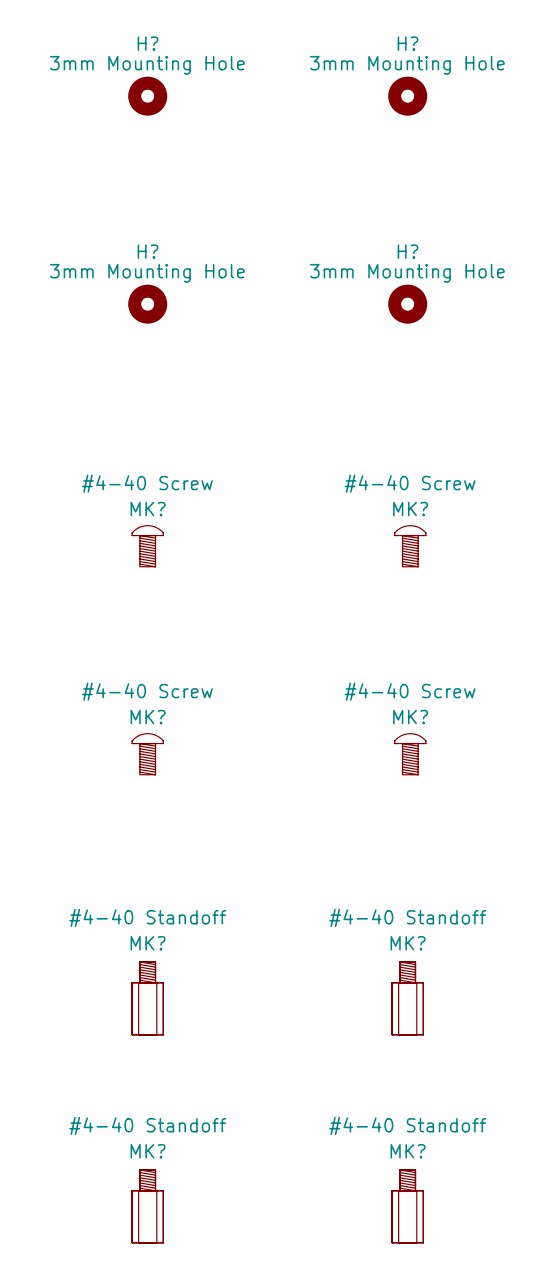
[picture p27: schematic mechanical.kicad_sch, USB Hub]

Parts:
H801, H802, H803, H804: 3mm Mounting Hole; MountingHole_3mm
MK801, MK802, MK807, MK808: #4-40 Screw; Digi-Key PN 36-9900-ND
MK803, MK804, MK805, MK806: #4-40 Standoff; Digi-Key PN 36-1892-ND

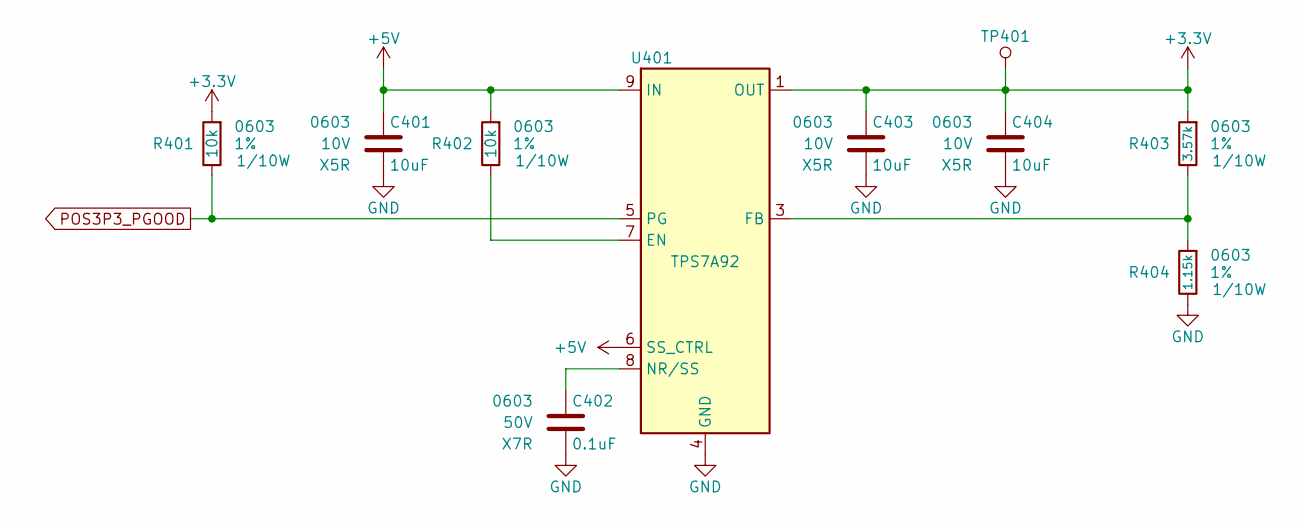
[picture p28: schematic POS3P3_Power_Supply.kicad_sch, USB Hub]

Parts:
C401, C403, C404: 10uF; C_0603; Voltage 10V; Digi-Key PN 399-8153-1-ND
C402: 0.1uF; C_0603; Voltage 50V; Digi-Key PN 1276-1935-1-ND
R401, R402: 10k; R_0603; Tolerance 1%; Digi-Key PN 541-10.0KHCT-ND
R403: 3.57k; R_0603; Tolerance 1%; Digi-Key PN 541-3.57KHCT-ND
R404: 1.15k; R_0603; Tolerance 1%; Digi-Key PN 541-1.15KHCT-ND
TP401: TP; Test_Point
U401: TPS7A92; Texas_S-PDSO-N10_EP1.2x2mm; Digi-Key PN TPS7A9201DSKR

Connections:
GND: C401.2, C402.2, C403.2, C404.2, R404.2, U401.4 (GND), U401.11 (GND); also elsewhere on the board
unnamed: R402.2, U401.7 (EN)
unnamed: R403.2, R404.1, U401.3 (FB)
unnamed: C402.1, U401.8 (NR/SS)
POS3P3_PGOOD: R401.2, U401.5 (PG); also elsewhere on the board
