drewsum/USB_Hub/hdw/USB_Hub/USB_Hub.kicad_pcb

## KiCad design hdw/USB_Hub/USB_Hub.kicad_pcb (continued)

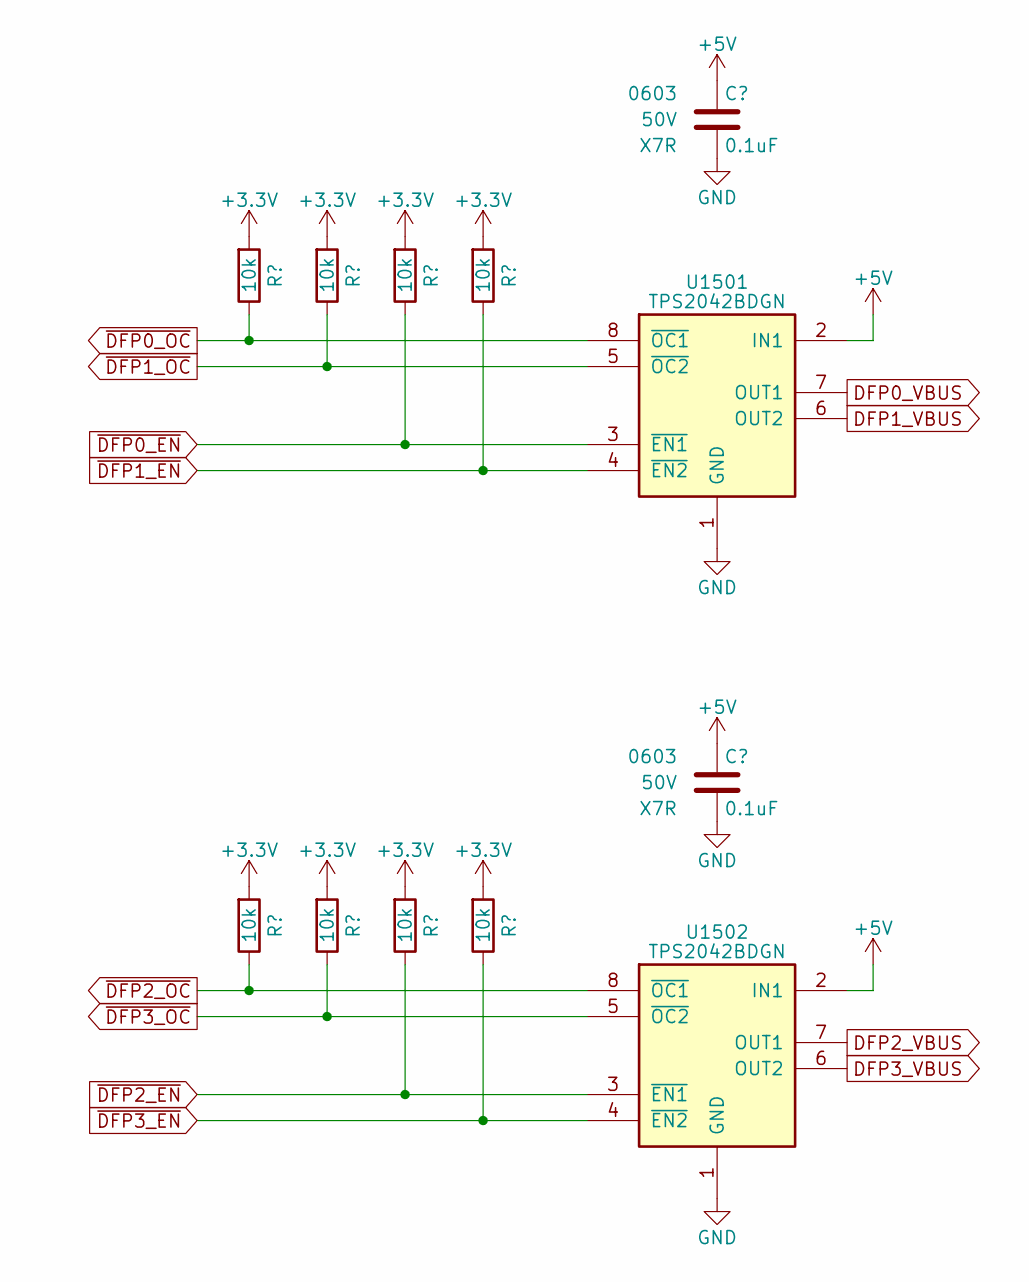
[picture p29: schematic port_power_control.kicad_sch, USB Hub]

Parts:
C1501, C1502: 0.1uF; C_0603; Voltage 50V; Digi-Key PN 1276-1935-1-ND
R1501, R1502, R1503, R1504, R1505, R1506, R1507, R1508: 10k; R_0603; Tolerance 1%; Digi-Key PN 541-10.0KHCT-ND
U1501, U1502: TPS2042BDGN; MSOP-8-1EP_3x3mm_Pitch0.65mm; Digi-Key PN 296-28003-1-ND

Connections:
DFP0_VBUS: U1501.7 (OUT1); also elsewhere on the board
DFP1_VBUS: U1501.6 (OUT2); also elsewhere on the board
DFP2_VBUS: U1502.7 (OUT1); also elsewhere on the board
DFP3_VBUS: U1502.6 (OUT2); also elsewhere on the board
GND: C1501.2, C1502.2, U1501.1 (GND), U1502.1 (GND); also elsewhere on the board
~DFP0_EN: R1505.2, U1501.3 (~EN1); also elsewhere on the board
~DFP0_OC: R1501.2, U1501.8 (~OC1); also elsewhere on the board
~DFP1_EN: R1507.2, U1501.4 (~EN2); also elsewhere on the board
~DFP1_OC: R1503.2, U1501.5 (~OC2); also elsewhere on the board
~DFP2_EN: R1506.2, U1502.3 (~EN1); also elsewhere on the board
~DFP2_OC: R1502.2, U1502.8 (~OC1); also elsewhere on the board
~DFP3_EN: R1508.2, U1502.4 (~EN2); also elsewhere on the board
~DFP3_OC: R1504.2, U1502.5 (~OC2); also elsewhere on the board

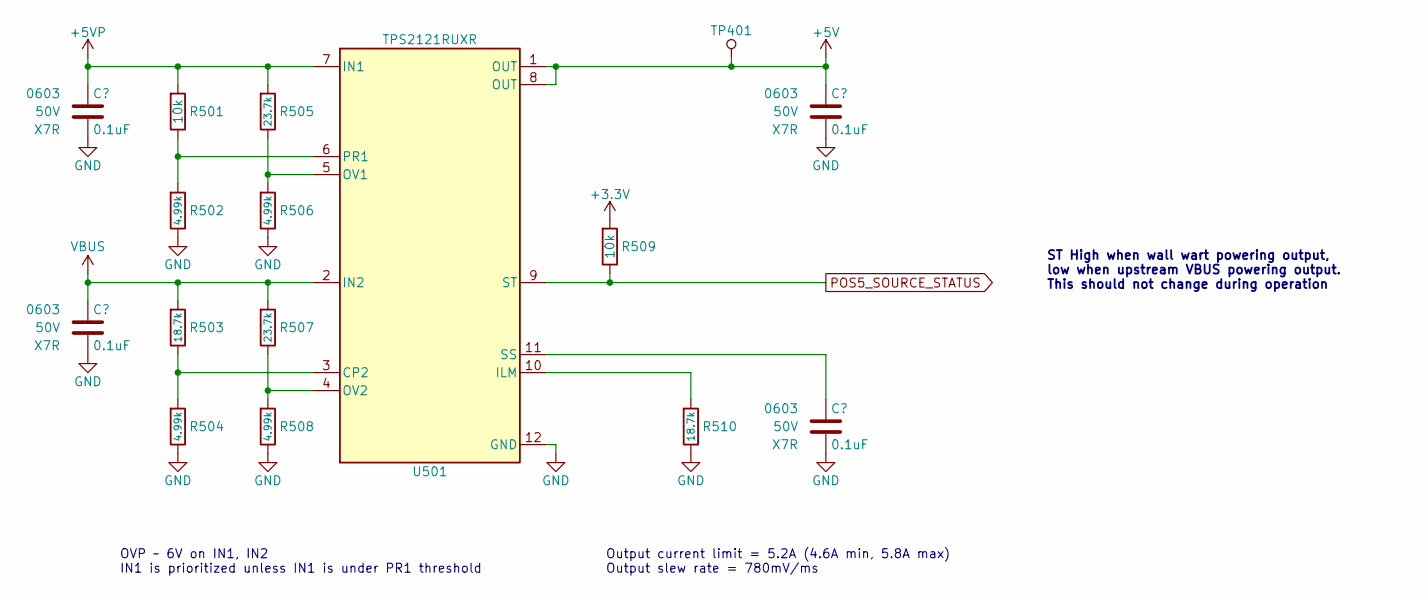
[picture p30: schematic power_oring.kicad_sch, USB Hub]

Parts:
C501, C502, C503, C504: 0.1uF; C_0603; Voltage 50V; Digi-Key PN 1276-1935-1-ND
R501, R509: 10k; R_0603; Tolerance 1%; Digi-Key PN 541-10.0KHCT-ND
R502, R504, R506, R508: 4.99k; R_0603; Tolerance 1%; Digi-Key PN 541-4.99KHCT-ND
R503, R510: 18.7k; R_0603; Tolerance 1%; Digi-Key PN 541-18.7KHCT-ND
R505, R507: 23.7k; R_0603; Tolerance 1%; Digi-Key PN 541-23.7KHCT-ND
TP401: TP; Test_Point
U501: TPS2121RUXR; 12-VQFN-HR_2x2p5; Digi-Key PN 296-53410-1-ND

Connections:
+5VP: C501.1, R501.1, R505.1, U501.7 (IN1); also elsewhere on the board
GND: C501.2, C502.2, C503.2, C504.2, R502.2, R504.2, R506.2, R508.2, R510.2, U501.12 (GND); also elsewhere on the board
unnamed: R503.2, R504.1, U501.3 (CP2)
unnamed: R510.1, U501.10 (ILM)
unnamed: R505.2, R506.1, U501.5 (OV1)
unnamed: R507.2, R508.1, U501.4 (OV2)
unnamed: R501.2, R502.1, U501.6 (PR1)
unnamed: C504.1, U501.11 (SS)
POS5_SOURCE_STATUS: R509.2, U501.9 (ST); also elsewhere on the board
VBUS: C502.1, R503.1, R507.1, U501.2 (IN2); also elsewhere on the board

Notes on the sheet:
ST High when wall wart powering output, low when upstream VBUS powering output. This should not change during operation
Output current limit = 5.2A (4.6A min, 5.8A max) Output slew rate = 780mV/ms
OVP ~ 6V on IN1, IN2 IN1 is prioritized unless IN1 is under PR1 threshold

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
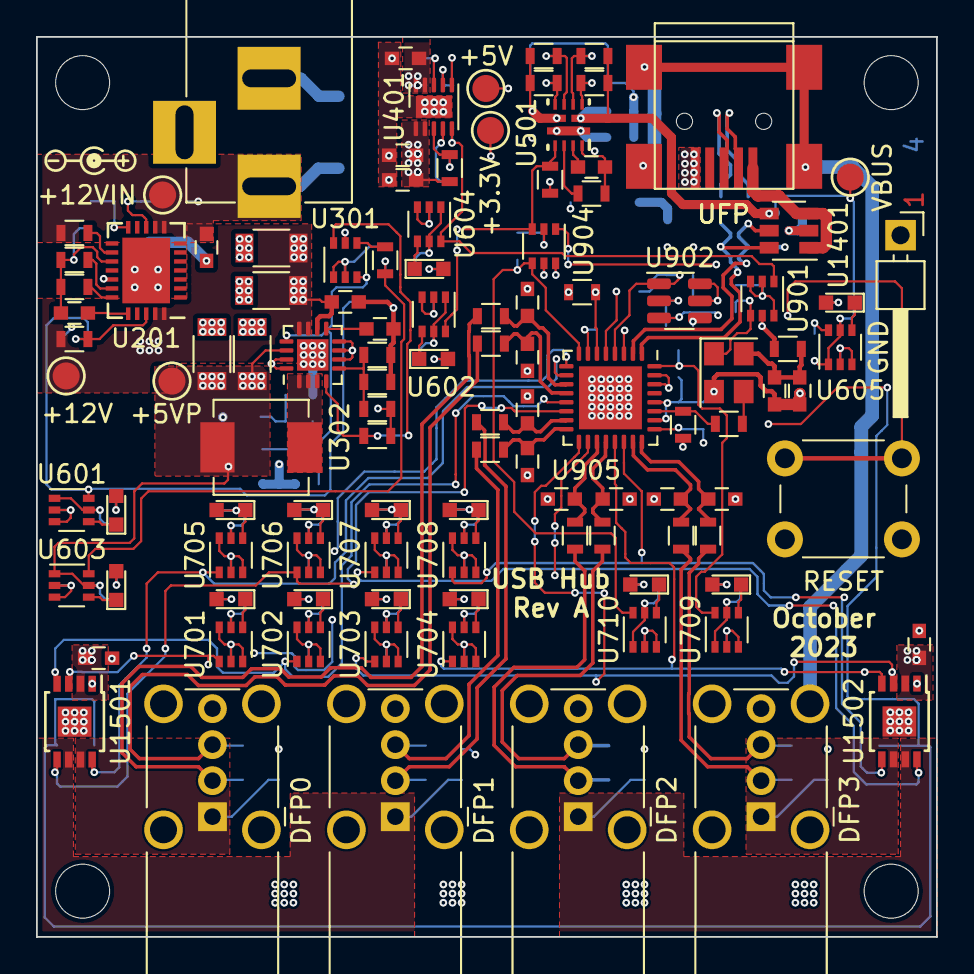
[picture p31: board USB_Hub.kicad_pcb from above]

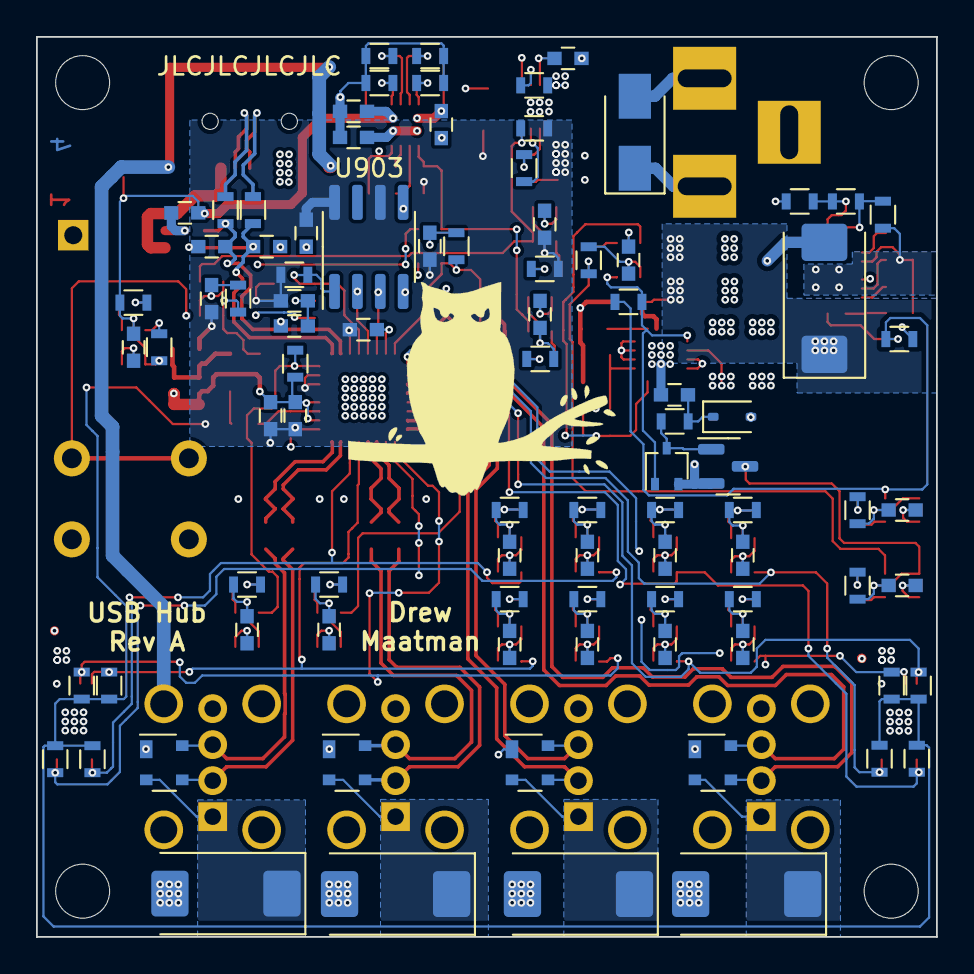
[picture p32: board USB_Hub.kicad_pcb from below]

Board: 4 copper layers, 50.0 x 50.0 mm, 204 parts (90 on the bottom side), 112 nets.

Other parts of the board:
TP501: TP; Test_Point
