drewsum/USB_Hub/(commit log)

2020-08-22 Started hdw project
    [Display.sch, Downstream_Port_0.sch, Downstream_Port_1.sch, Downstream_Port_2.sch, Downstream_Port_3.sch, Downstream_Port_4.sch, Downstream_Port_5.sch, Hub_Controller.sch]
2023-08-06 wokrked on this some more
    [Display.kicad_sch, Downstream_Port_0.kicad_sch, Downstream_Port_1.kicad_sch, Downstream_Port_2.kicad_sch, Downstream_Port_3.kicad_sch, Downstream_Port_4.kicad_sch, Downstream_Port_5.kicad_sch, Hub_Controller.kicad_sch]
2023-08-10 added new 4 port USB hub controller
    [Display.sch, Downstream_Port_0.sch, Downstream_Port_1.sch, Downstream_Port_2.sch, Downstream_Port_3.sch, Downstream_Port_4.kicad_sch, Downstream_Port_4.sch, Downstream_Port_5.kicad_sch]
2023-08-11 schematic progress
    [Hub_Controller.kicad_sch, PGOOD_LEDs.kicad_sch, PIC18F_Core.kicad_sch, PIC18F_Programming.kicad_sch, POS12_Input.kicad_sch, POS5_Power_Supply.kicad_sch, POS5_Telemetry.kicad_sch, USB_Hub.kicad_sch]
2023-08-18 lots of schematic progress
    [Downstream_Port_0.kicad_sch, Downstream_Port_1.kicad_sch, Downstream_Port_2.kicad_sch, Downstream_Port_3.kicad_sch, Hub_Controller.kicad_sch, Hub_LEDs.kicad_sch, PGOOD_LEDs.kicad_sch, PIC18F_Core.kicad_sch]
2023-08-18 much more schematic progress
    [Hub_Controller.kicad_sch, Hub_LEDs.kicad_sch, PGOOD_LEDs.kicad_sch, PIC18F_Core.kicad_sch, POS12_Input.kicad_sch, POS3P3_Power_Supply.kicad_sch, POS3P3_Telemetry.kicad_sch, POS5_Telemetry.kicad_sch]
2023-08-20 lots and lots of sch progress
    [Display.kicad_sch, Downstream_Port_0.kicad_sch, Downstream_Port_1.kicad_sch, Downstream_Port_2.kicad_sch, Downstream_Port_3.kicad_sch, Hub_Controller.kicad_sch, Hub_LEDs.kicad_sch, PGOOD_LEDs.kicad_sch]
2023-08-20 pulled footprints into layout
    [Display.kicad_sch, Downstream_Port_0.kicad_sch, Downstream_Port_1.kicad_sch, Downstream_Port_2.kicad_sch, Downstream_Port_3.kicad_sch, Hub_Controller.kicad_sch, Hub_LEDs.kicad_sch, PGOOD_LEDs.kicad_sch]
2023-08-21 random stuff
    [USB_Hub.kicad_pcb]
2023-09-06 big restructuring, removed microcontroller and all telemtry
    [Display.kicad_sch, Downstream_Port_0.kicad_sch, Downstream_Port_1.kicad_sch, Downstream_Port_2.kicad_sch, Downstream_Port_3.kicad_sch, Hub_Controller.kicad_sch, Hub_LEDs.kicad_sch, PGOOD_LEDs.kicad_sch]
2023-09-06 fixed footprints, assigned digikey pns
    [Downstream_Port_0.kicad_sch, Downstream_Port_1.kicad_sch, Downstream_Port_2.kicad_sch, Downstream_Port_3.kicad_sch, Hub_Controller.kicad_sch, Hub_LEDs.kicad_sch, PGOOD_LEDs.kicad_sch, POS12_Input.kicad_sch]
2023-09-15 pulled in fotprints into layout
    [Downstream_Port_0.kicad_sch, Hub_Controller.kicad_sch, PGOOD_LEDs.kicad_sch, POS12_Input.kicad_sch, POS3P3_Power_Supply.kicad_sch, POS5_Power_Supply.kicad_sch, USB_Hub.kicad_pcb, USB_Hub.kicad_sch]
2023-09-15 pulled in design rules
    [USB_Hub.kicad_pcb]
2023-09-15 some component placement
    [POS5_Power_Supply.kicad_sch, USB_Hub.kicad_pcb]
2023-09-15 VBUS power switch placement
    [USB_Hub.kicad_pcb]
2023-09-16 fixed some netlist connectivity issues, finished grouping parts in PCB
    [Downstream_Port_0.kicad_sch, Downstream_Port_1.kicad_sch, Downstream_Port_2.kicad_sch, Downstream_Port_3.kicad_sch, Hub_Controller.kicad_sch, Hub_LEDs.kicad_sch, USB_Hub.kicad_pcb, Upstream_Port.kicad_sch]
2023-09-17 created board outline
    [USB_Hub.kicad_pcb]
2023-09-17 finished placing parts in baoard outline
    [USB_Hub.kicad_pcb, power_oring.kicad_sch]
2023-09-17 added GND plane
    [USB_Hub.kicad_pcb]
2023-09-17 lots of PCB progress, fixed some netlist issues
    [Downstream_Port_2.kicad_sch, USB_Hub.kicad_pcb]
2023-10-02 routed diff pairs
    [USB_Hub.kicad_pcb]
2023-10-02 random routing, via placement
    [USB_Hub.kicad_pcb]
2023-10-06 random power and signal routing
    [USB_Hub.kicad_pcb]
2023-10-06 lots of misc routing
    [USB_Hub.kicad_pcb]
2023-10-06 much more routing
    [USB_Hub.kicad_pcb]
2023-10-08 got unconnects to 0
    [USB_Hub.kicad_pcb]
2023-10-08 added some random PCB silkscreen/misc things
    [USB_Hub.kicad_pcb]
2023-10-14 generated BOM
    [USB_Hub_bom.csv]
